eayaras/Proyecto/final.jpeg

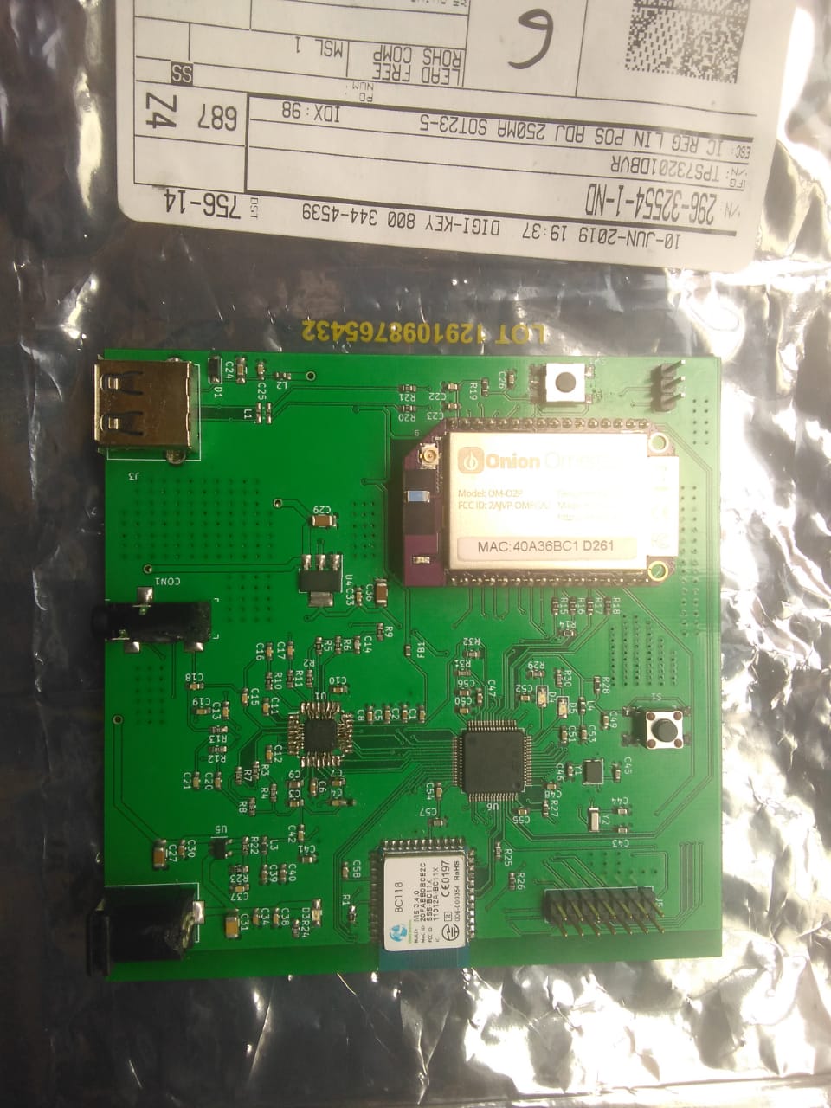
final.jpeg
