eayaras/Proyecto/omega_opt(1).jpg

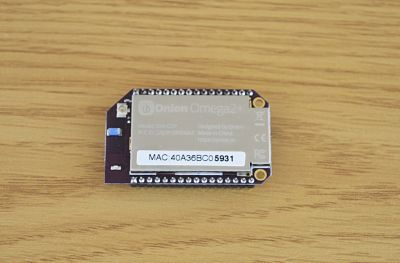
omega_opt(1).jpg
