eayaras/Proyecto/blue.JPG

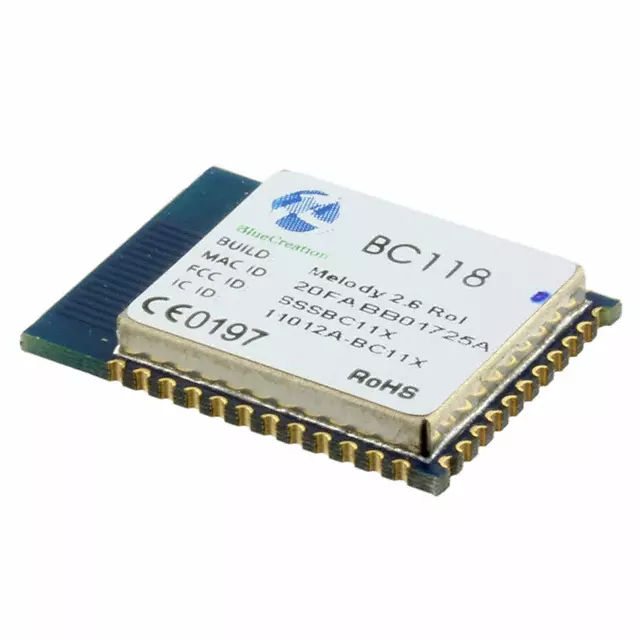
blue.JPG
