eayaras/Proyecto/CApainferior.png

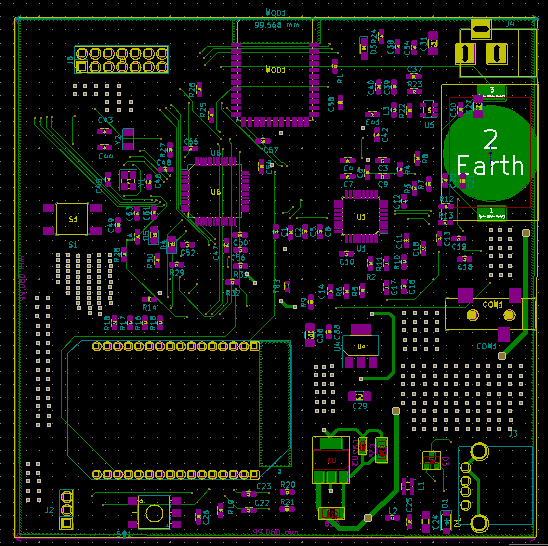
CApainferior.png
