eayaras/Proyecto/capasuperior.png

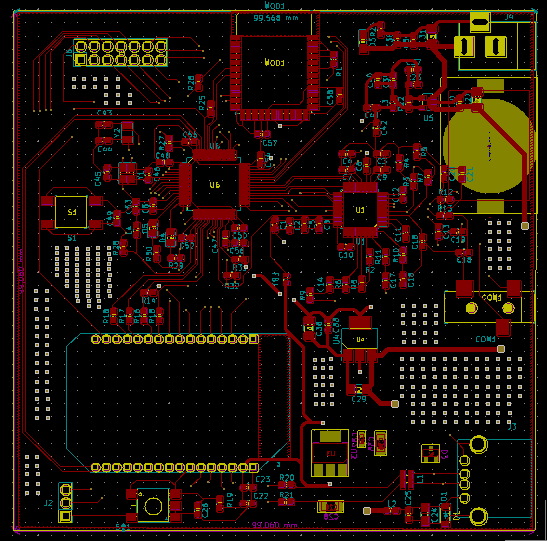
capasuperior.png
