eayaras/Proyecto/CIrcuitoIMpreso.png

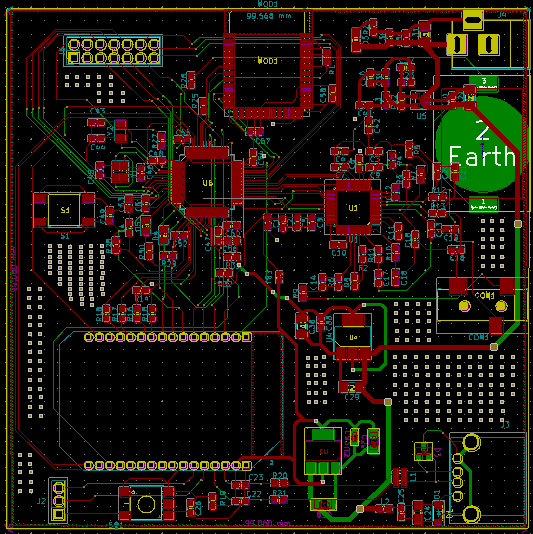
CIrcuitoIMpreso.png
