eayaras/Proyecto/corre.jpeg

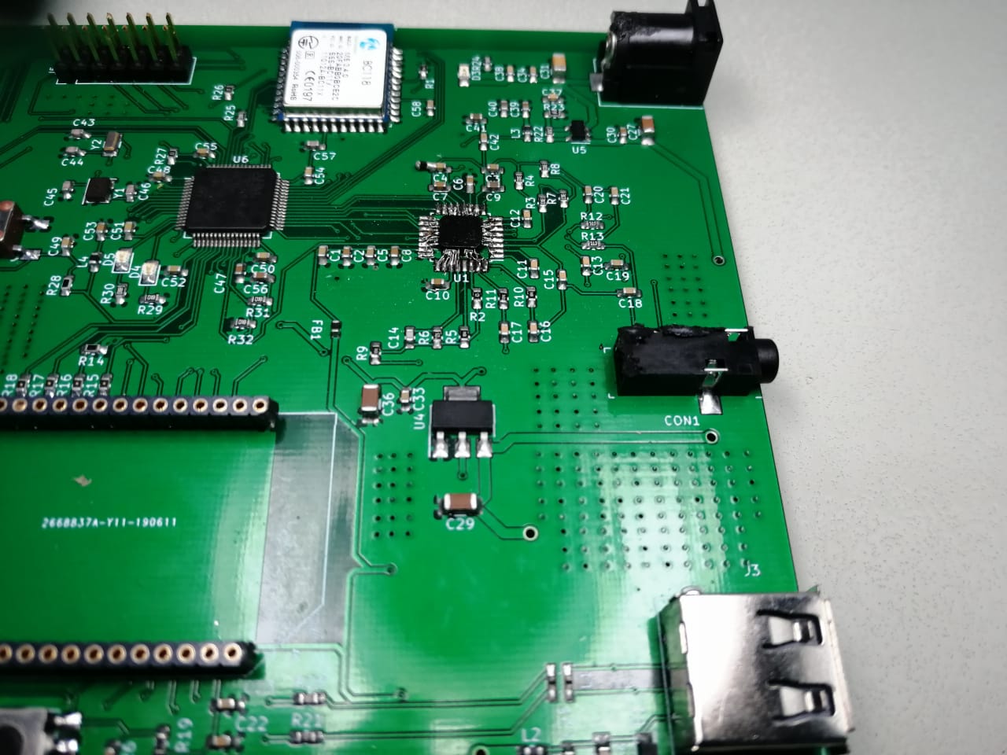
corre.jpeg
