eayaras/Proyecto/emb_3D2.png

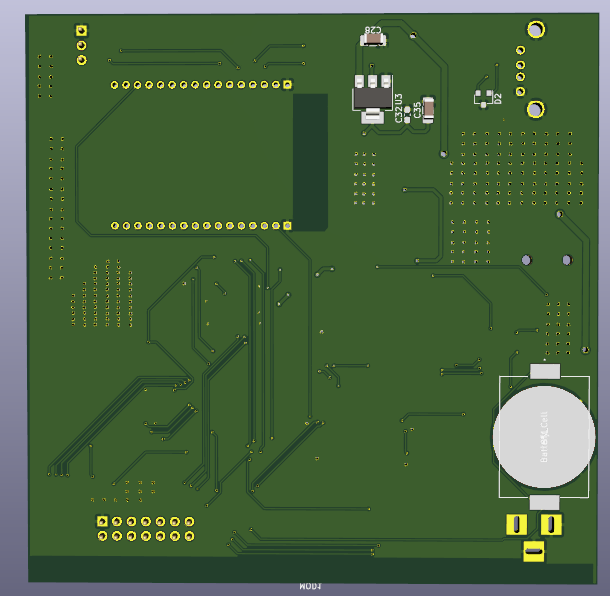
emb_3D2.png
