eayaras/Proyecto/emb_3D.png

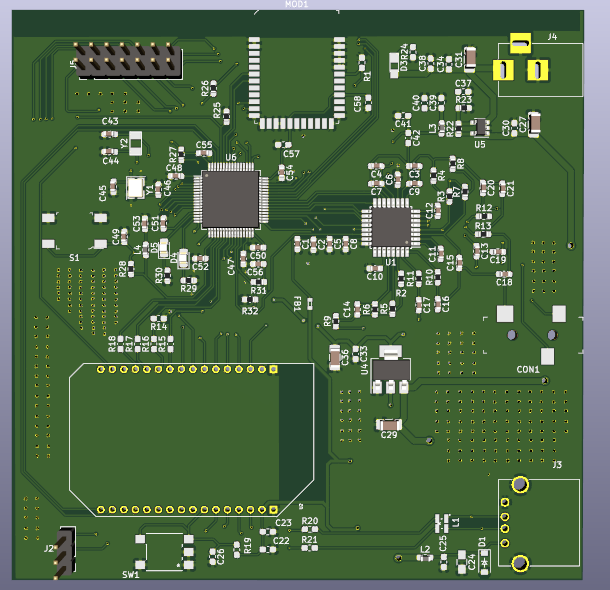
emb_3D.png
