eayaras/Proyecto/Esquema general.jpg

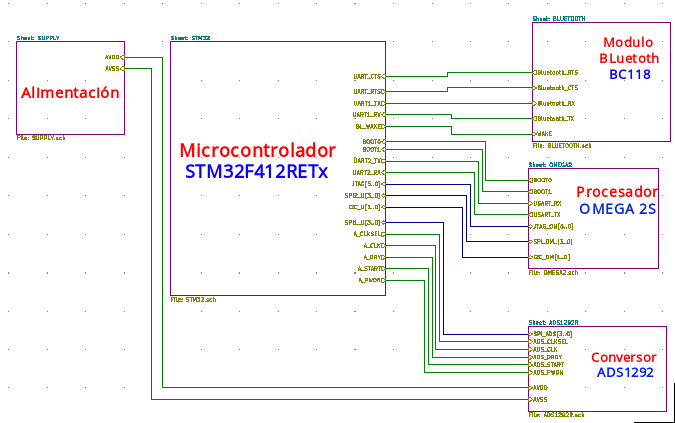
Esquema general.jpg
