eayaras/Proyecto/mainc.PNG

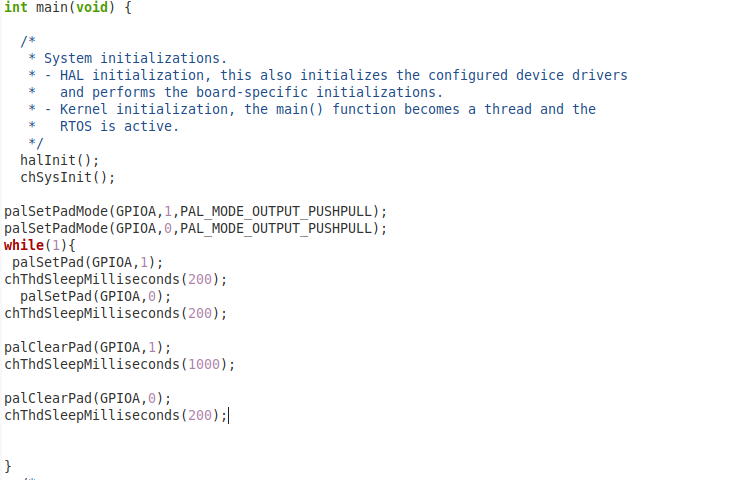
mainc.PNG
