eayaras/Proyecto/micro.png

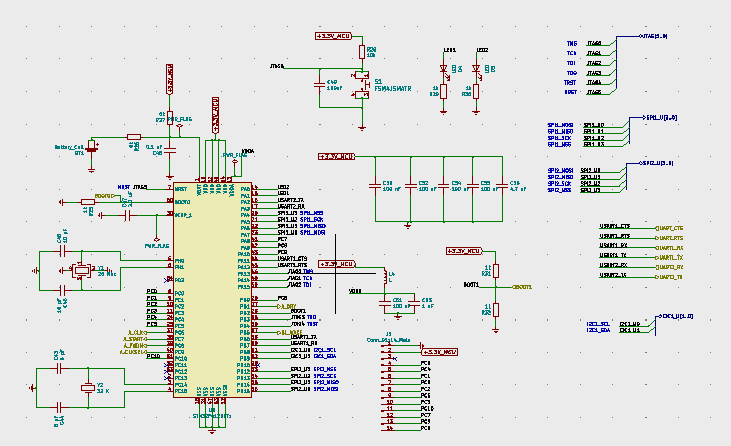
micro.png
