eayaras/Proyecto/mod_ads.png

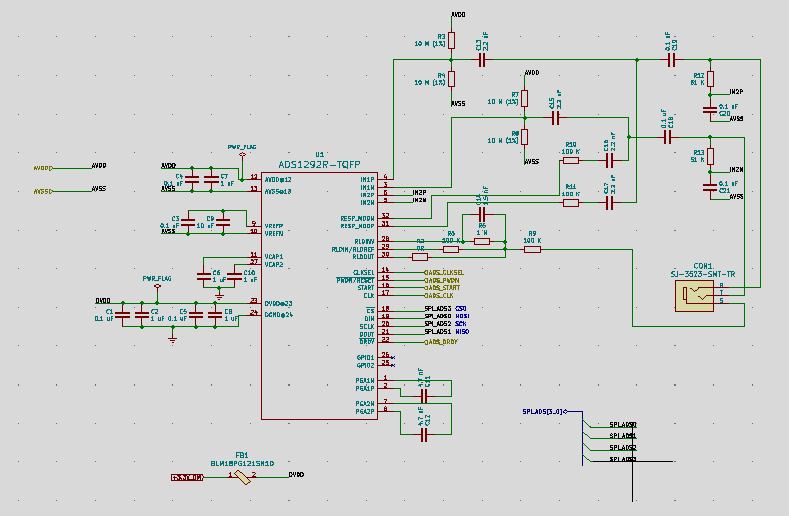
mod_ads.png
