eayaras/Proyecto/mod_bluetooth.png

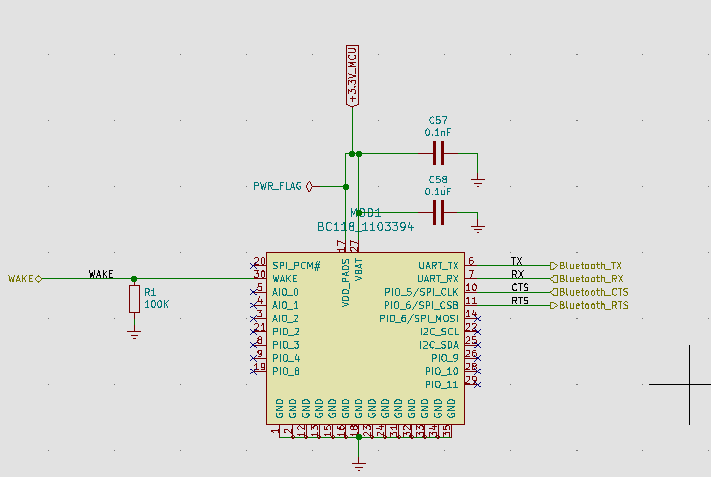
mod_bluetooth.png
