eayaras/Proyecto/onion.cfg.PNG

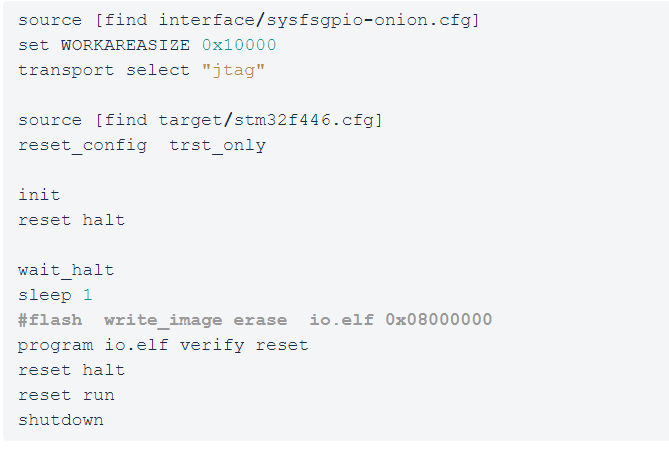
onion.cfg.PNG
