eayaras/Proyecto/onion.png

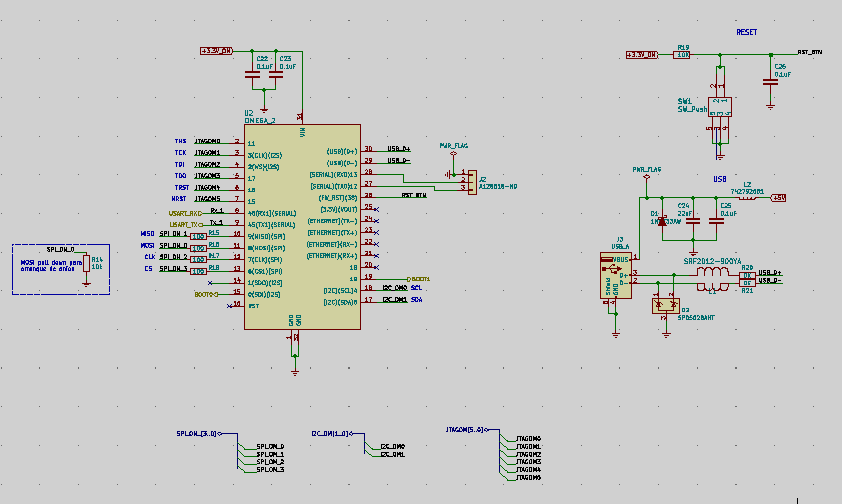
onion.png
