eayaras/Proyecto/script_programa.PNG

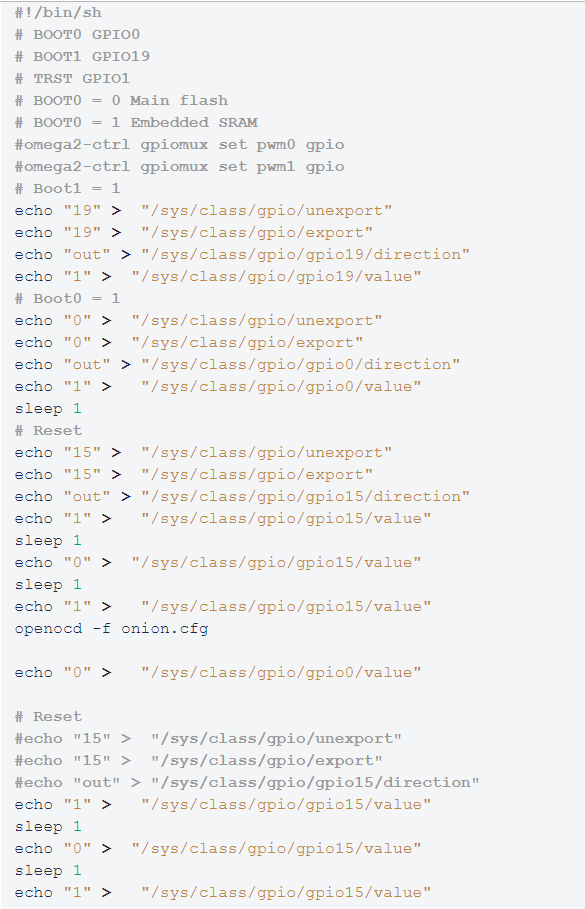
script_programa.PNG
