eayaras/Proyecto/stm.jpg

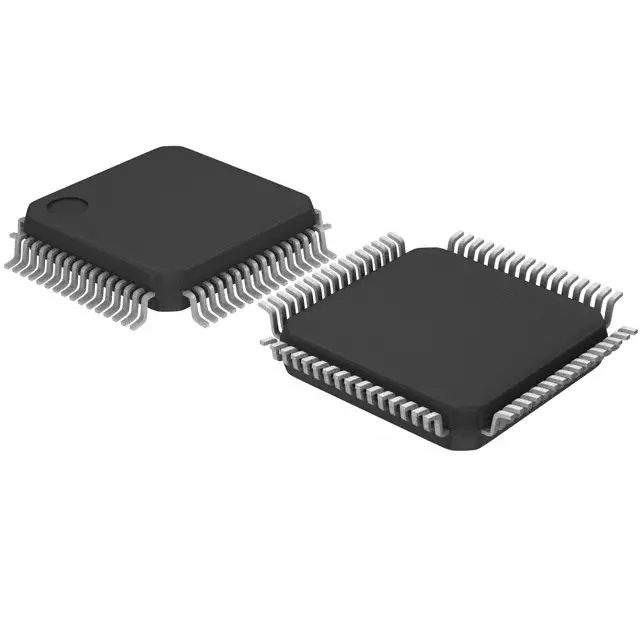
stm.jpg
