eayaras/Proyecto/supply1.png

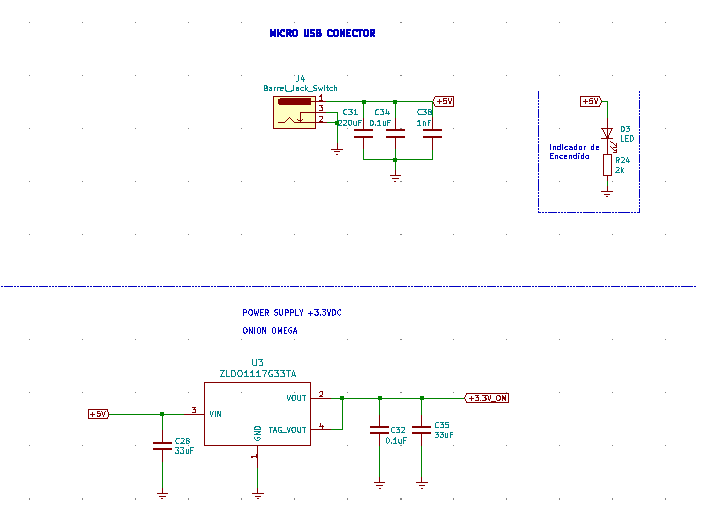
supply1.png
