eayaras/Proyecto/supply2.png

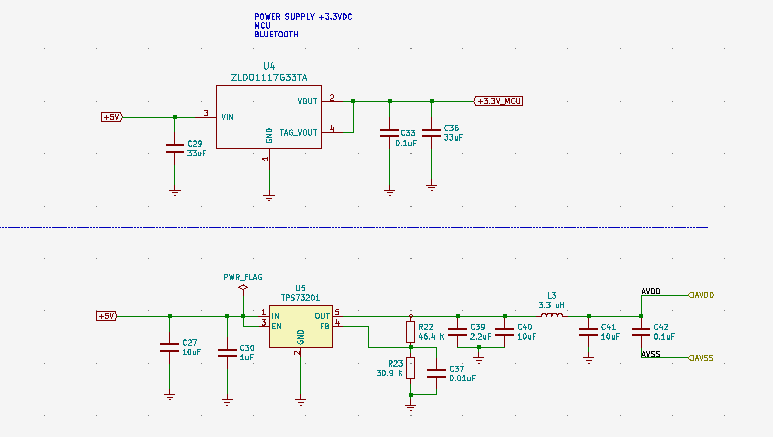
supply2.png
