eayaras/Proyecto/tarjetai.jpeg

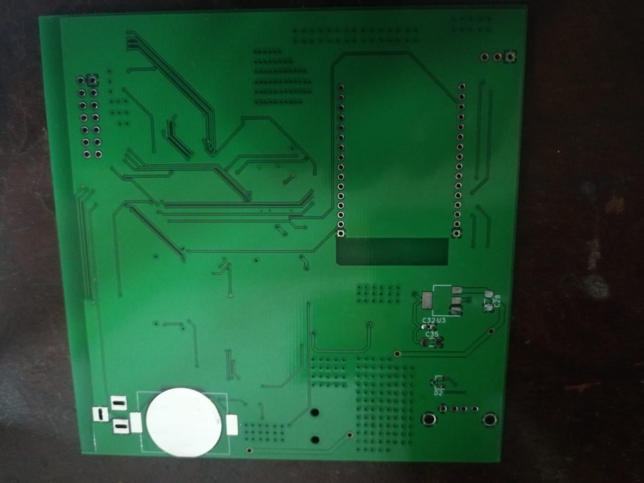
tarjetai.jpeg
