eayaras/Proyecto/tarjetas.jpeg

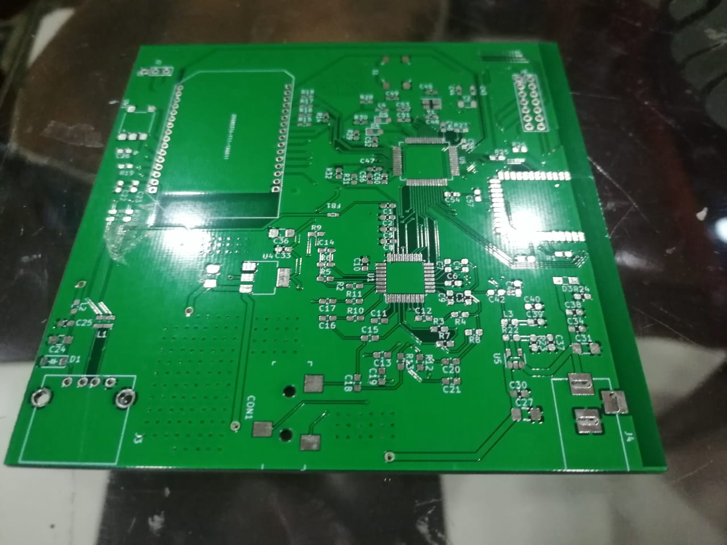
tarjetas.jpeg
