eayaras/Proyecto/Embebidos_2019.pdf

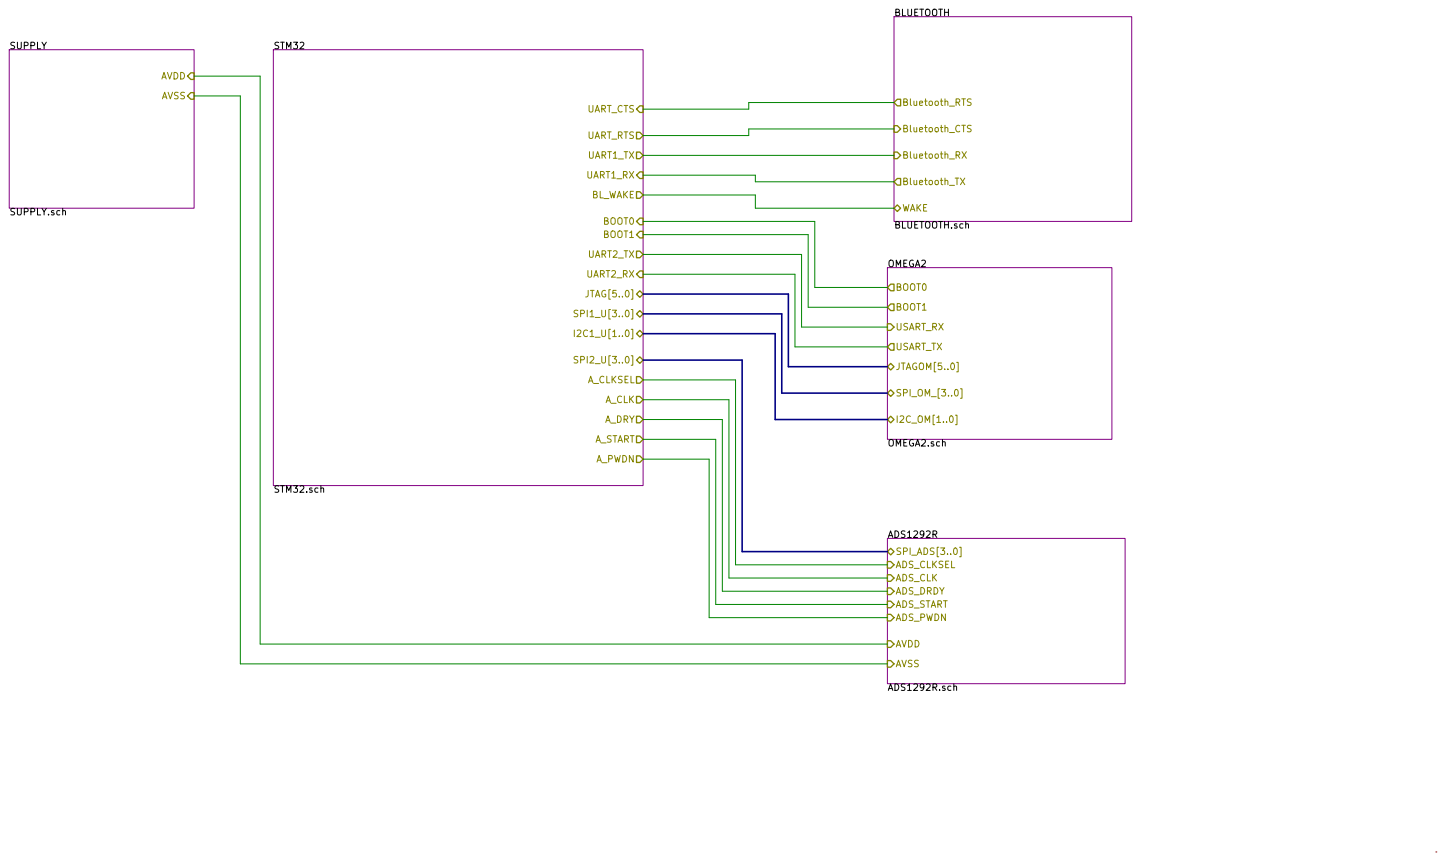
[picture p23: page 1]

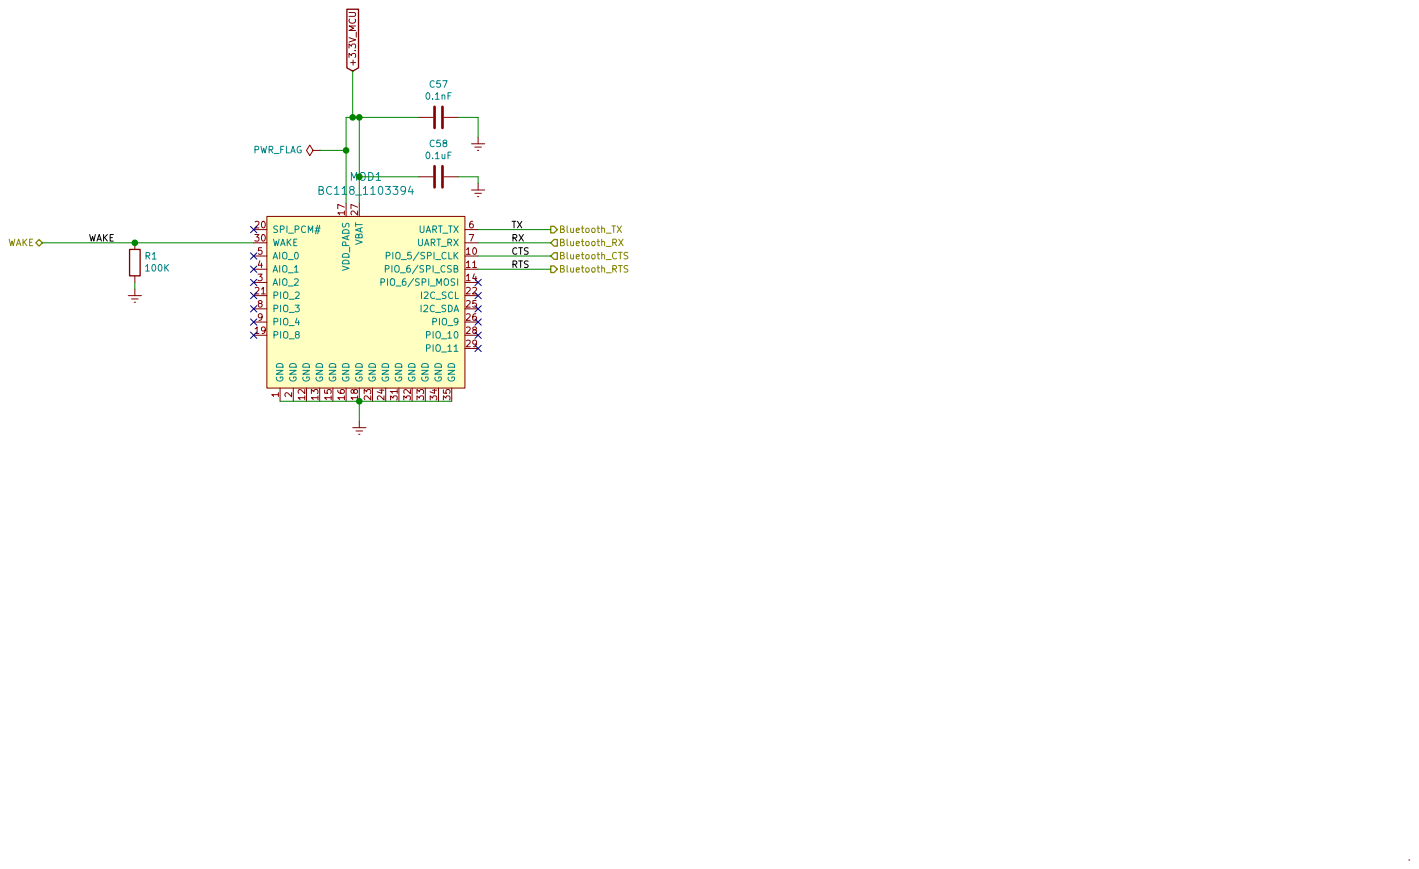
[picture p24: page 2]

GND 1 GND 2 AIO_2 3 AIO_1 4 AIO_0 5 UART_TX 6 UART_RX 7 PIO_3 8 PIO_4 9 PIO_5/SPI_CLK 10 SPI_PCM# 20 WAKE 30 PIO_6/SPI_CSB 11 PIO_2 21 GND 31 GND 12

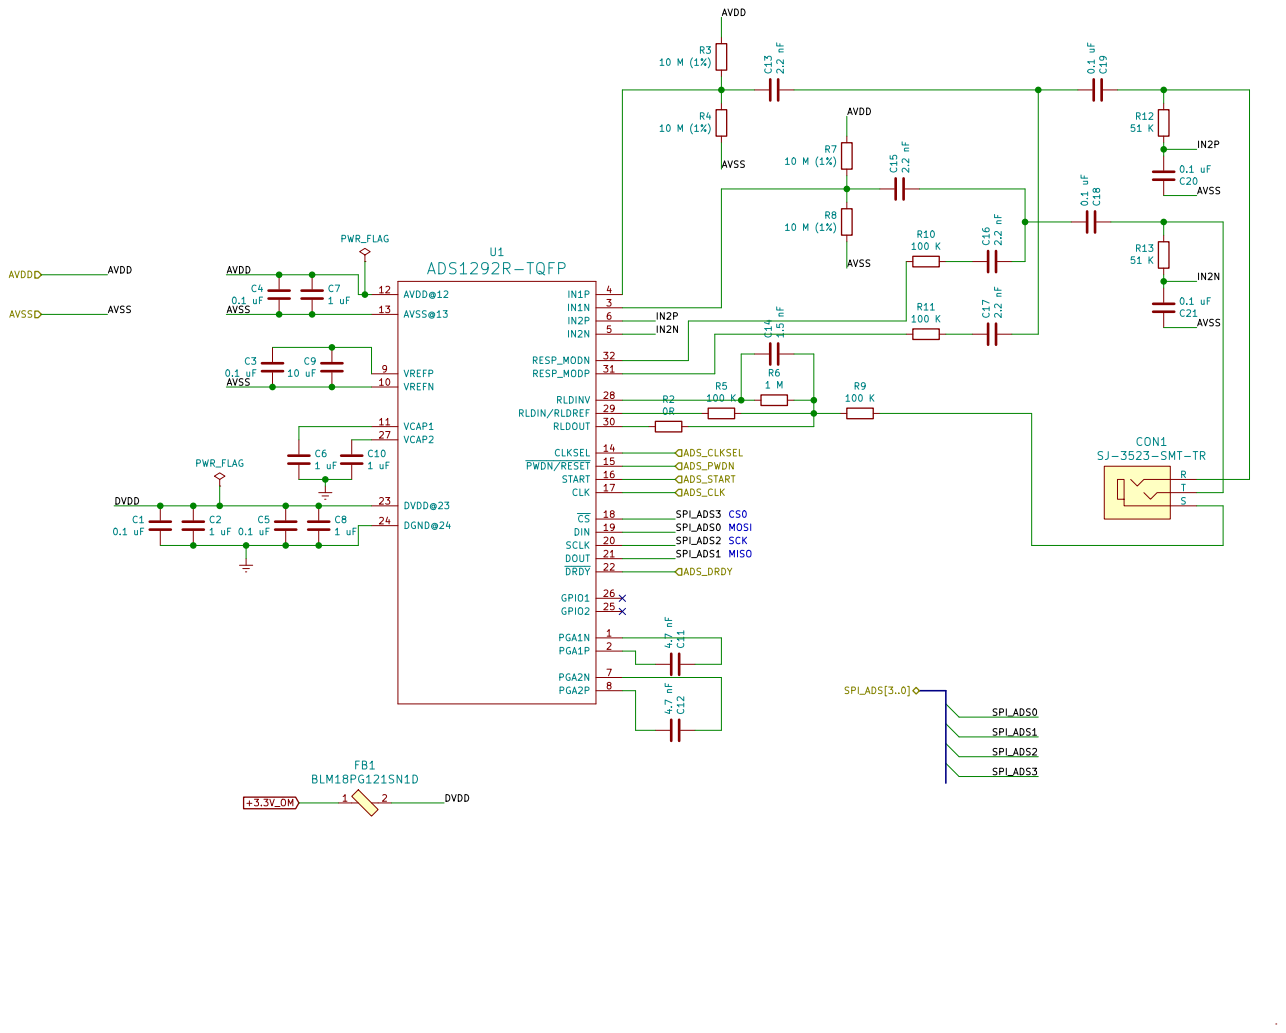
[picture p25: page 3]

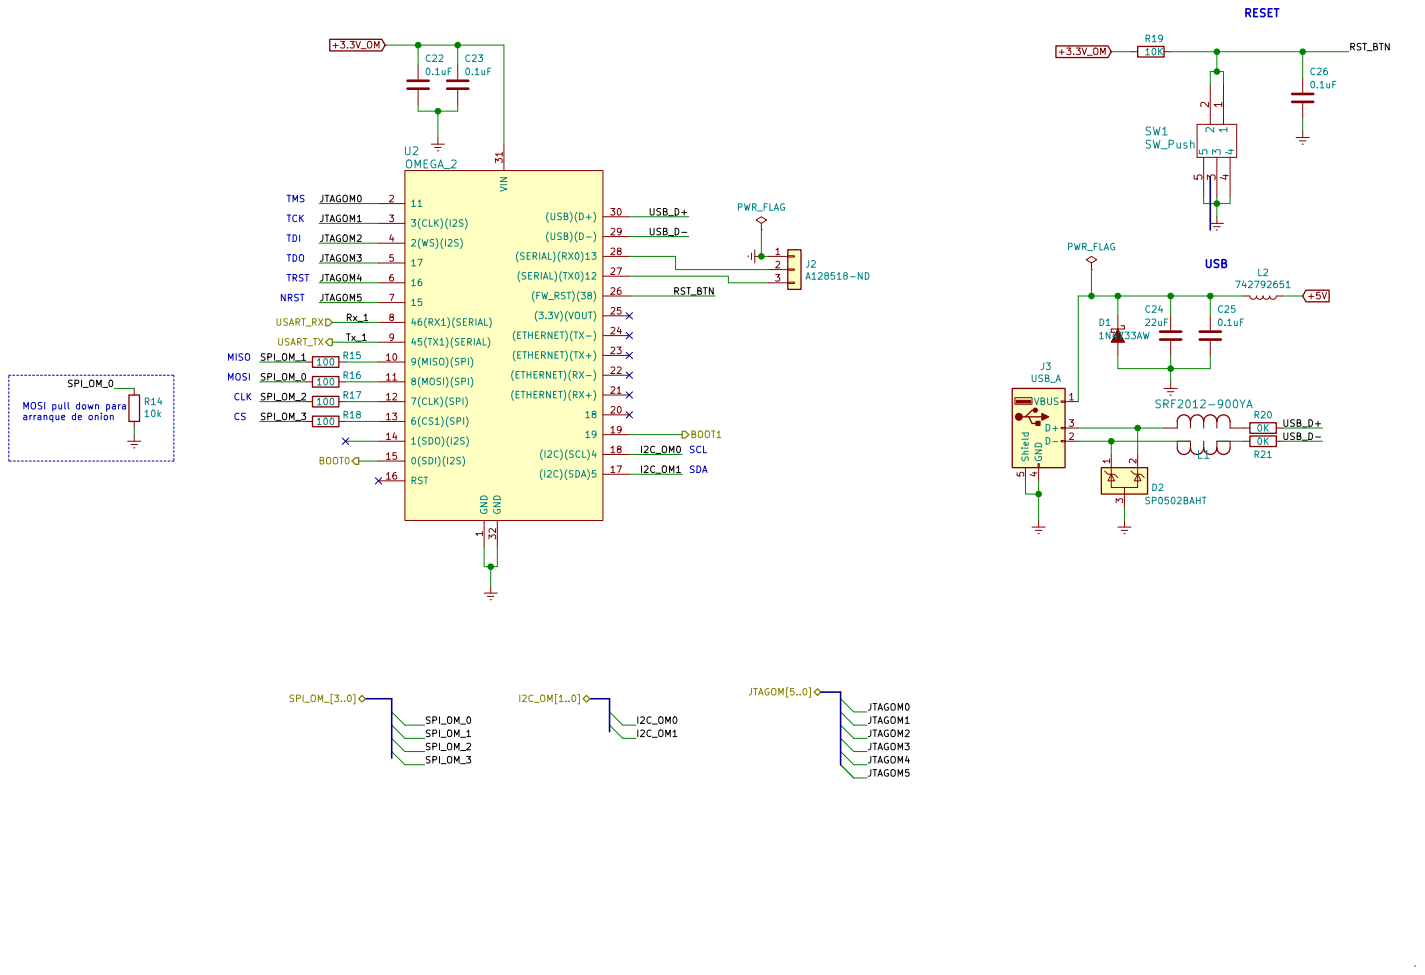
[picture p26: page 4]

10k MOSI pull down para
arranque de onion

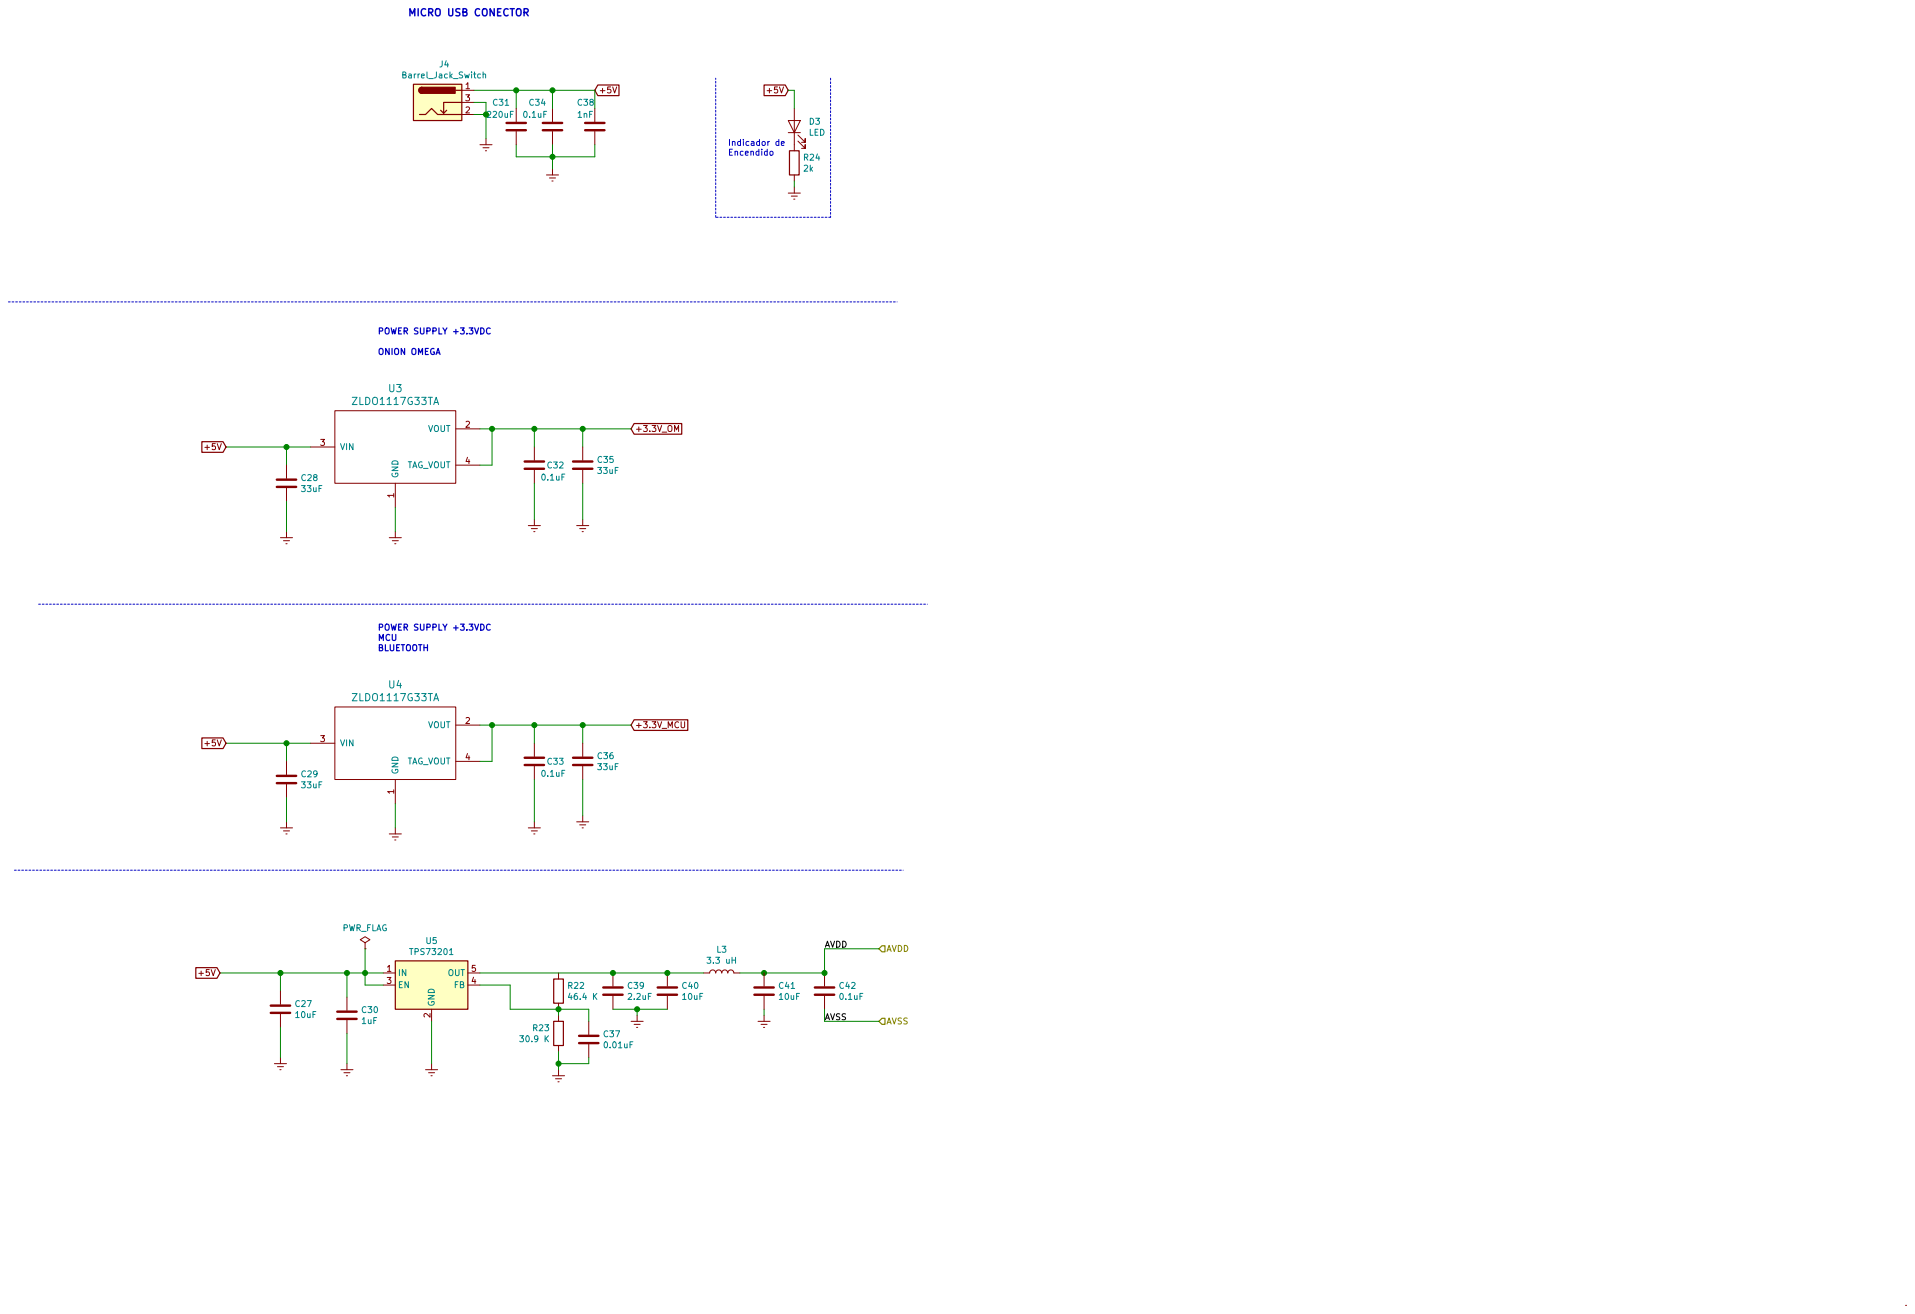
[picture p27: page 5]

0.1uF POWER SUPPLY +3.3VDC ONION OMEGA GND

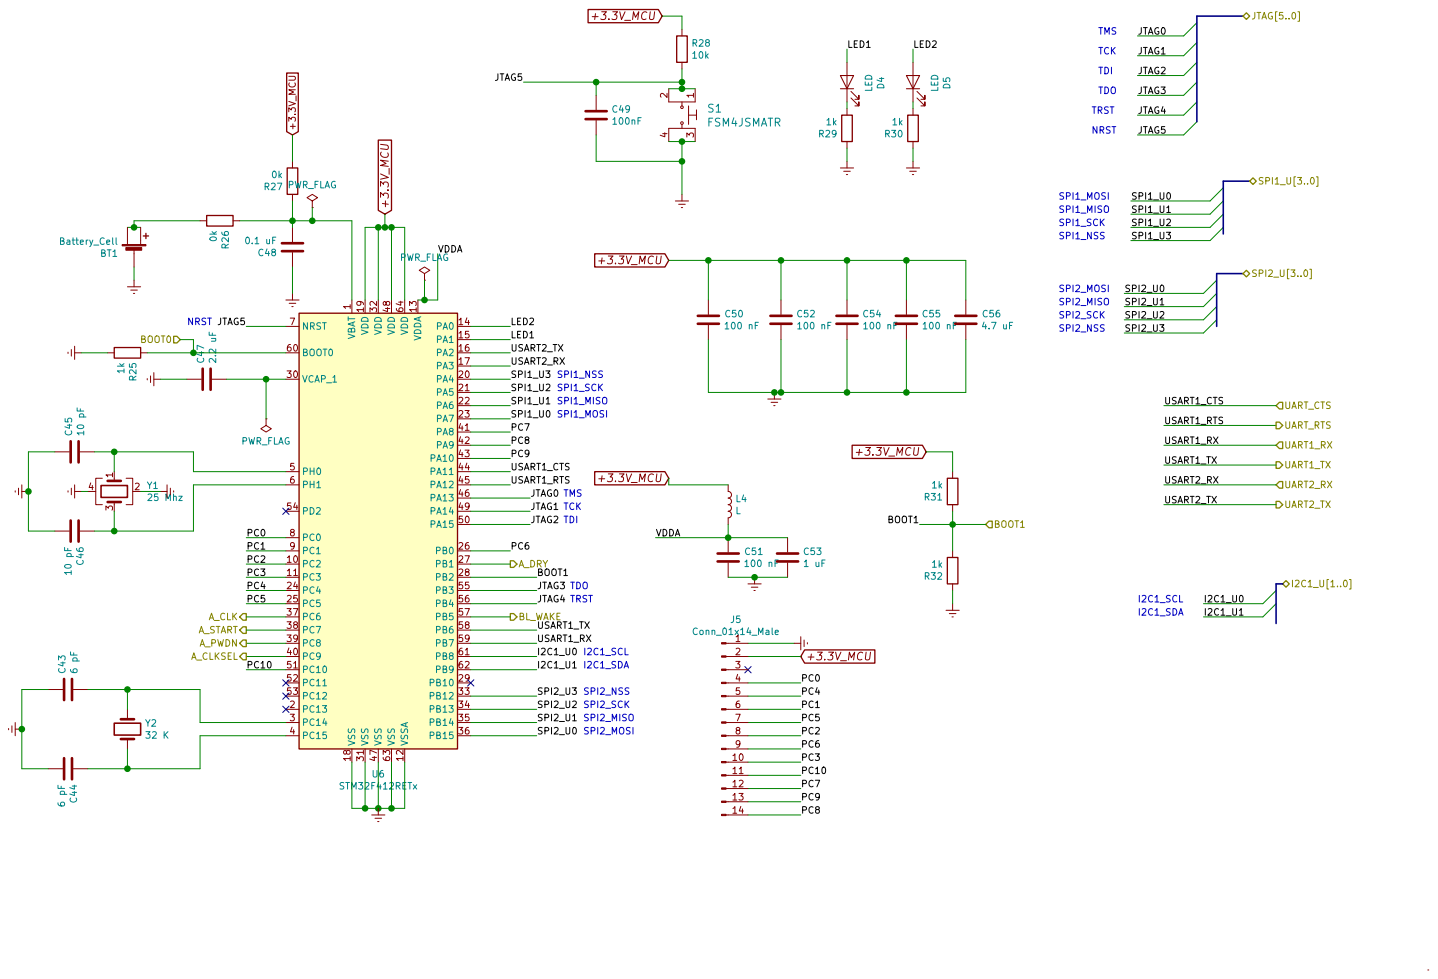
[picture p28: page 6]

1 VCAP_1 30 VDD 19 VDD 32 VDD 48 VDD 64 VDDA 13 VSS 18 VSS 31 VSS 47 VSS 63 VSSA 12 U6 STM32F412RETx
