eayaras/Proyecto/Embebidos_2019/Proyecto-master/Embebidos_2019/Embebidos_2019.kicad_pcb

## KiCad design Embebidos_2019/Proyecto-master/Embebidos_2019/Embebidos_2019.kicad_pcb (2019-06-09)

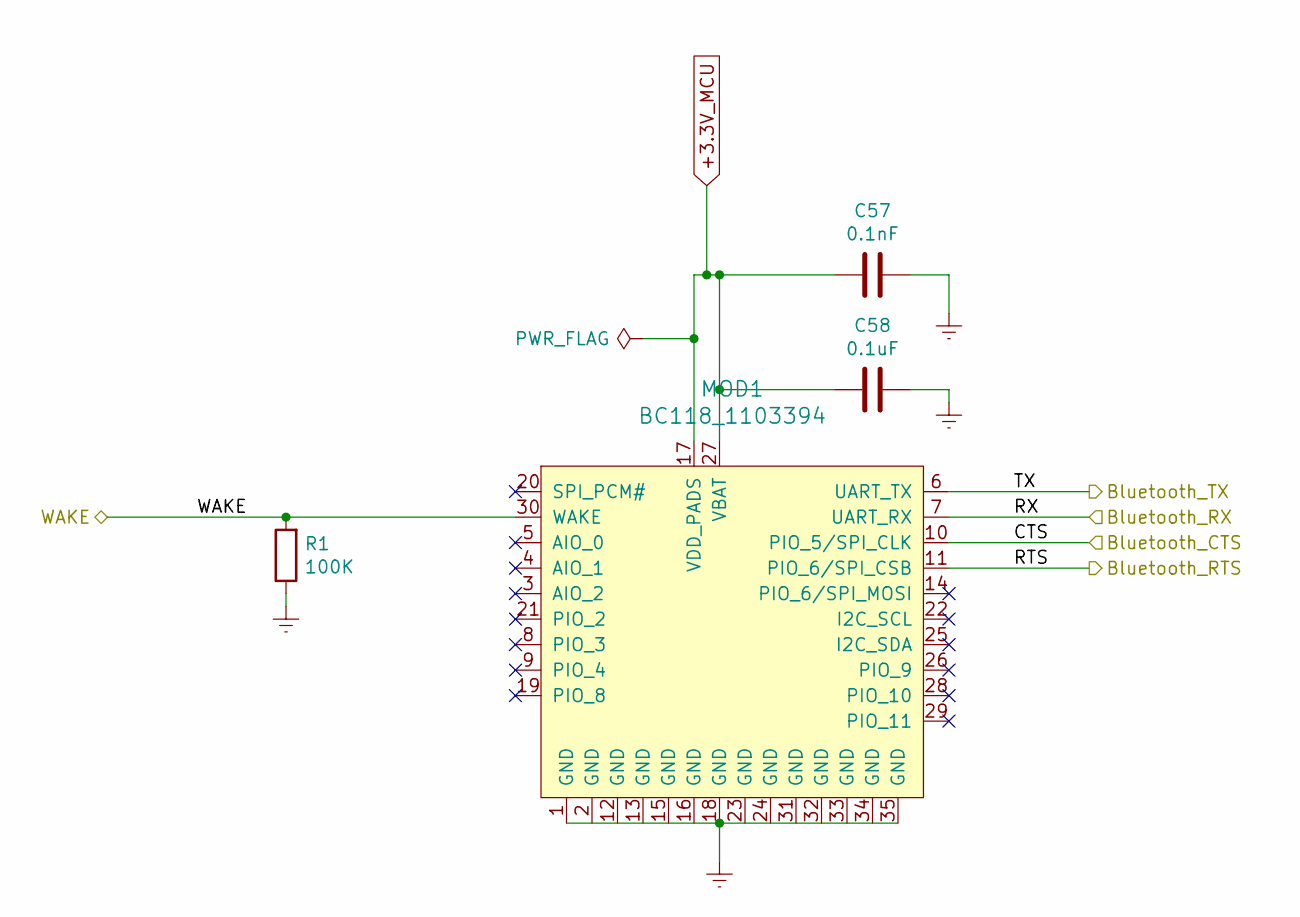
[picture p29: schematic BLUETOOTH.sch]

Parts:
C57: 0.1nF; C_0603_1608Metric_Pad1.05x0.95mm_HandSolder
C58: 0.1uF; C_0603_1608Metric_Pad1.05x0.95mm_HandSolder
MOD1: BC118_1103394; Bluetooth_Module_BC118; MPN BC118_1103394; Digi-Key_PN 1495-1003-1-ND
R1: 100K; R_0603_1608Metric_Pad1.05x0.95mm_HandSolder

Connections:
+3.3V_MCU: C57.2, C58.2, MOD1.17 (VDD_PADS), MOD1.27 (VBAT); also elsewhere on the board
/BLUETOOTH/Bluetooth_RTS: MOD1.11 (PIO_6/SPI_CSB); also elsewhere on the board
/BLUETOOTH/Bluetooth_TX: MOD1.6 (UART_TX); also elsewhere on the board
/STM32/BL_WAKE: MOD1.30 (WAKE), R1.2; also elsewhere on the board
/STM32/UART1_TX: MOD1.7 (UART_RX); also elsewhere on the board
/STM32/UART_RTS: MOD1.10 (PIO_5/SPI_CLK); also elsewhere on the board
Earth: C57.1, C58.1, MOD1.1 (GND), MOD1.2 (GND), MOD1.12 (GND), MOD1.13 (GND), MOD1.15 (GND), MOD1.16 (GND), MOD1.18 (GND), MOD1.23 (GND), MOD1.24 (GND), MOD1.31 (GND), MOD1.32 (GND), MOD1.33 (GND), MOD1.34 (GND), MOD1.35 (GND), R1.1; also elsewhere on the board

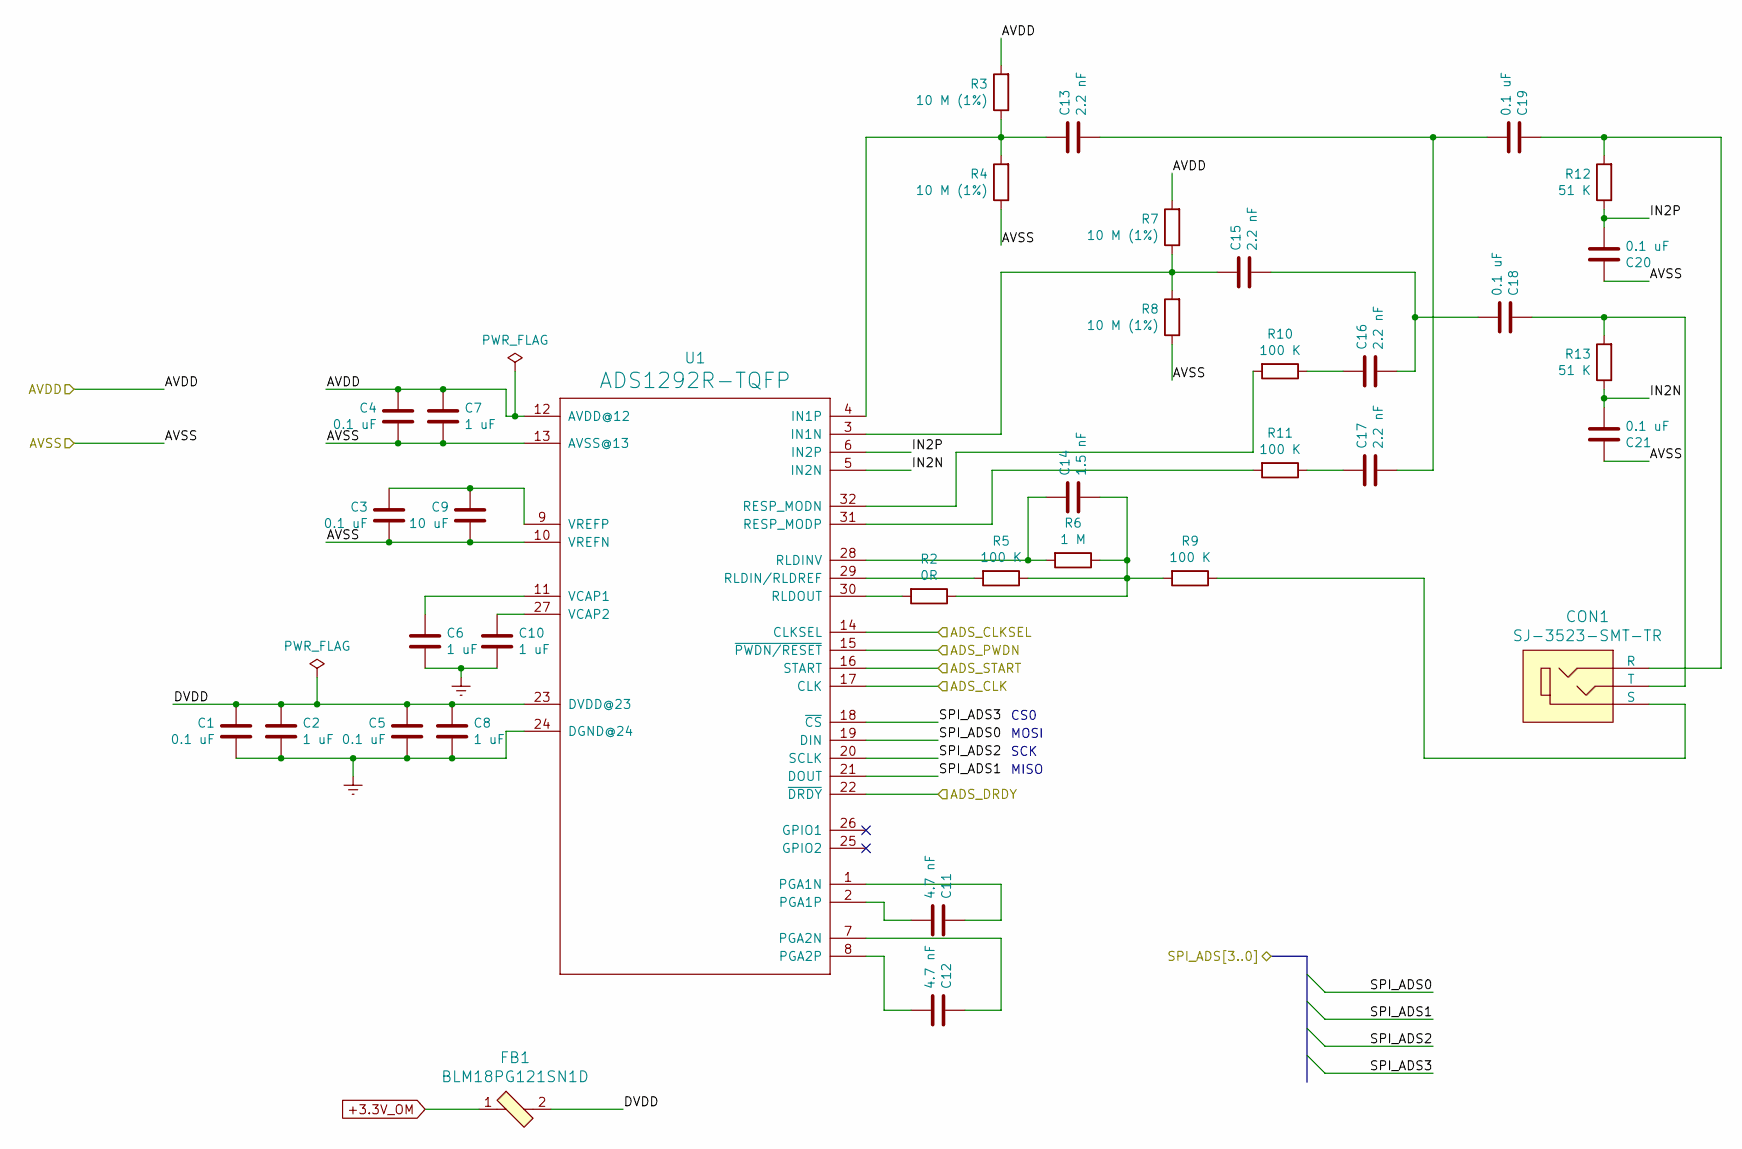
[picture p30: schematic ADS1292R.sch]

Parts:
C1, C3, C4, C5, C18, C19, C20, C21: 0.1 uF; C_0603_1608Metric_Pad1.05x0.95mm_HandSolder
C2, C6, C7, C8, C10: 1 uF; C_0603_1608Metric_Pad1.05x0.95mm_HandSolder
C9: 10 uF; C_0603_1608Metric_Pad1.05x0.95mm_HandSolder
C11, C12: 4.7 nF; C_0603_1608Metric_Pad1.05x0.95mm_HandSolder
C13, C15, C16, C17: 2.2 nF; C_0603_1608Metric_Pad1.05x0.95mm_HandSolder
C14: 1.5 nF; C_0603_1608Metric_Pad1.05x0.95mm_HandSolder
CON1: SJ-3523-SMT-TR; Switch_Slide_11.6x4mm_SJ-3523-SMT; MPN SJ-3523-SMT-TR; Digi-Key_PN CP-3523SJCT-ND
FB1: BLM18PG121SN1D; 0603; MPN BLM18PG121SN1D; Digi-Key_PN 490-1037-1-ND
R2: 0R; R_0603_1608Metric_Pad1.05x0.95mm_HandSolder
R3, R4, R7, R8: 10 M (1%); R_0603_1608Metric_Pad1.05x0.95mm_HandSolder
R5, R9, R10, R11: 100 K; R_0603_1608Metric_Pad1.05x0.95mm_HandSolder
R6: 1 M; R_0603_1608Metric_Pad1.05x0.95mm_HandSolder
R12, R13: 51 K; R_0603_1608Metric_Pad1.05x0.95mm_HandSolder
U1: ADS1292R-TQFP; TQFP-32_7x7mm_P0.8mm

Connections:
+3.3V_OM: FB1.1; also elsewhere on the board
/ADS1292R/AVDD: C4.1, C7.1, R3.2, R7.2, U1.12 (AVDD@12); also elsewhere on the board
/ADS1292R/DVDD: C1.1, C2.1, C5.1, C8.1, FB1.2, U1.23 (DVDD@23)
/ADS1292R/IN2N: C21.2, R13.1, U1.5 (IN2N)
/ADS1292R/IN2P: C20.2, R12.1, U1.6 (IN2P)
/ADS1292R/SPI_ADS0: U1.19 (DIN); also elsewhere on the board
/ADS1292R/SPI_ADS1: U1.21 (DOUT); also elsewhere on the board
/ADS1292R/SPI_ADS2: U1.20 (SCLK); also elsewhere on the board
/ADS1292R/SPI_ADS3: U1.18 (~CS); also elsewhere on the board
/STM32/A_CLK: U1.17 (CLK); also elsewhere on the board
/STM32/A_CLKSEL: U1.14 (CLKSEL); also elsewhere on the board
/STM32/A_DRY: U1.22 (~DRDY); also elsewhere on the board
/STM32/A_PWDN: U1.15 (~PWDN/RESET); also elsewhere on the board
/STM32/A_START: U1.16 (START); also elsewhere on the board
/SUPPLY/AVSS: C3.2, C4.2, C7.2, C9.2, C20.1, C21.1, R4.1, R8.1, U1.10 (VREFN), U1.13 (AVSS@13); also elsewhere on the board
Earth: C1.2, C2.2, C5.2, C6.2, C8.2, C10.2, U1.24 (DGND@24); also elsewhere on the board
unnamed: C3.1, C9.1, U1.9 (VREFP)
unnamed: C6.1, U1.11 (VCAP1)
unnamed: C10.1, U1.27 (VCAP2)
unnamed: C11.1, U1.1 (PGA1N)
unnamed: C11.2, U1.2 (PGA1P)
unnamed: C12.1, U1.7 (PGA2N)
unnamed: C12.2, U1.8 (PGA2P)
unnamed: C13.1, R3.1, R4.2, U1.4 (IN1P)
unnamed: C13.2, C17.2, C19.2
unnamed: C14.1, R6.2, U1.28 (RLDINV)
unnamed: C14.2, R2.1, R5.1, R6.1, R9.2
unnamed: C15.1, R7.1, R8.2, U1.3 (IN1N)
unnamed: C15.2, C16.2, C18.2
unnamed: C16.1, R10.1
unnamed: C17.1, R11.1
unnamed: C18.1, CON1.2 (T), R13.2
unnamed: C19.1, CON1.3 (R), R12.2
unnamed: CON1.1 (S), R9.1
unnamed: R2.2, U1.30 (RLDOUT)
unnamed: R5.2, U1.29 (RLDIN/RLDREF)
unnamed: R10.2, U1.32 (RESP_MODN)
unnamed: R11.2, U1.31 (RESP_MODP)

Notes on the sheet:
MOSI
MISO
SCK
CS0

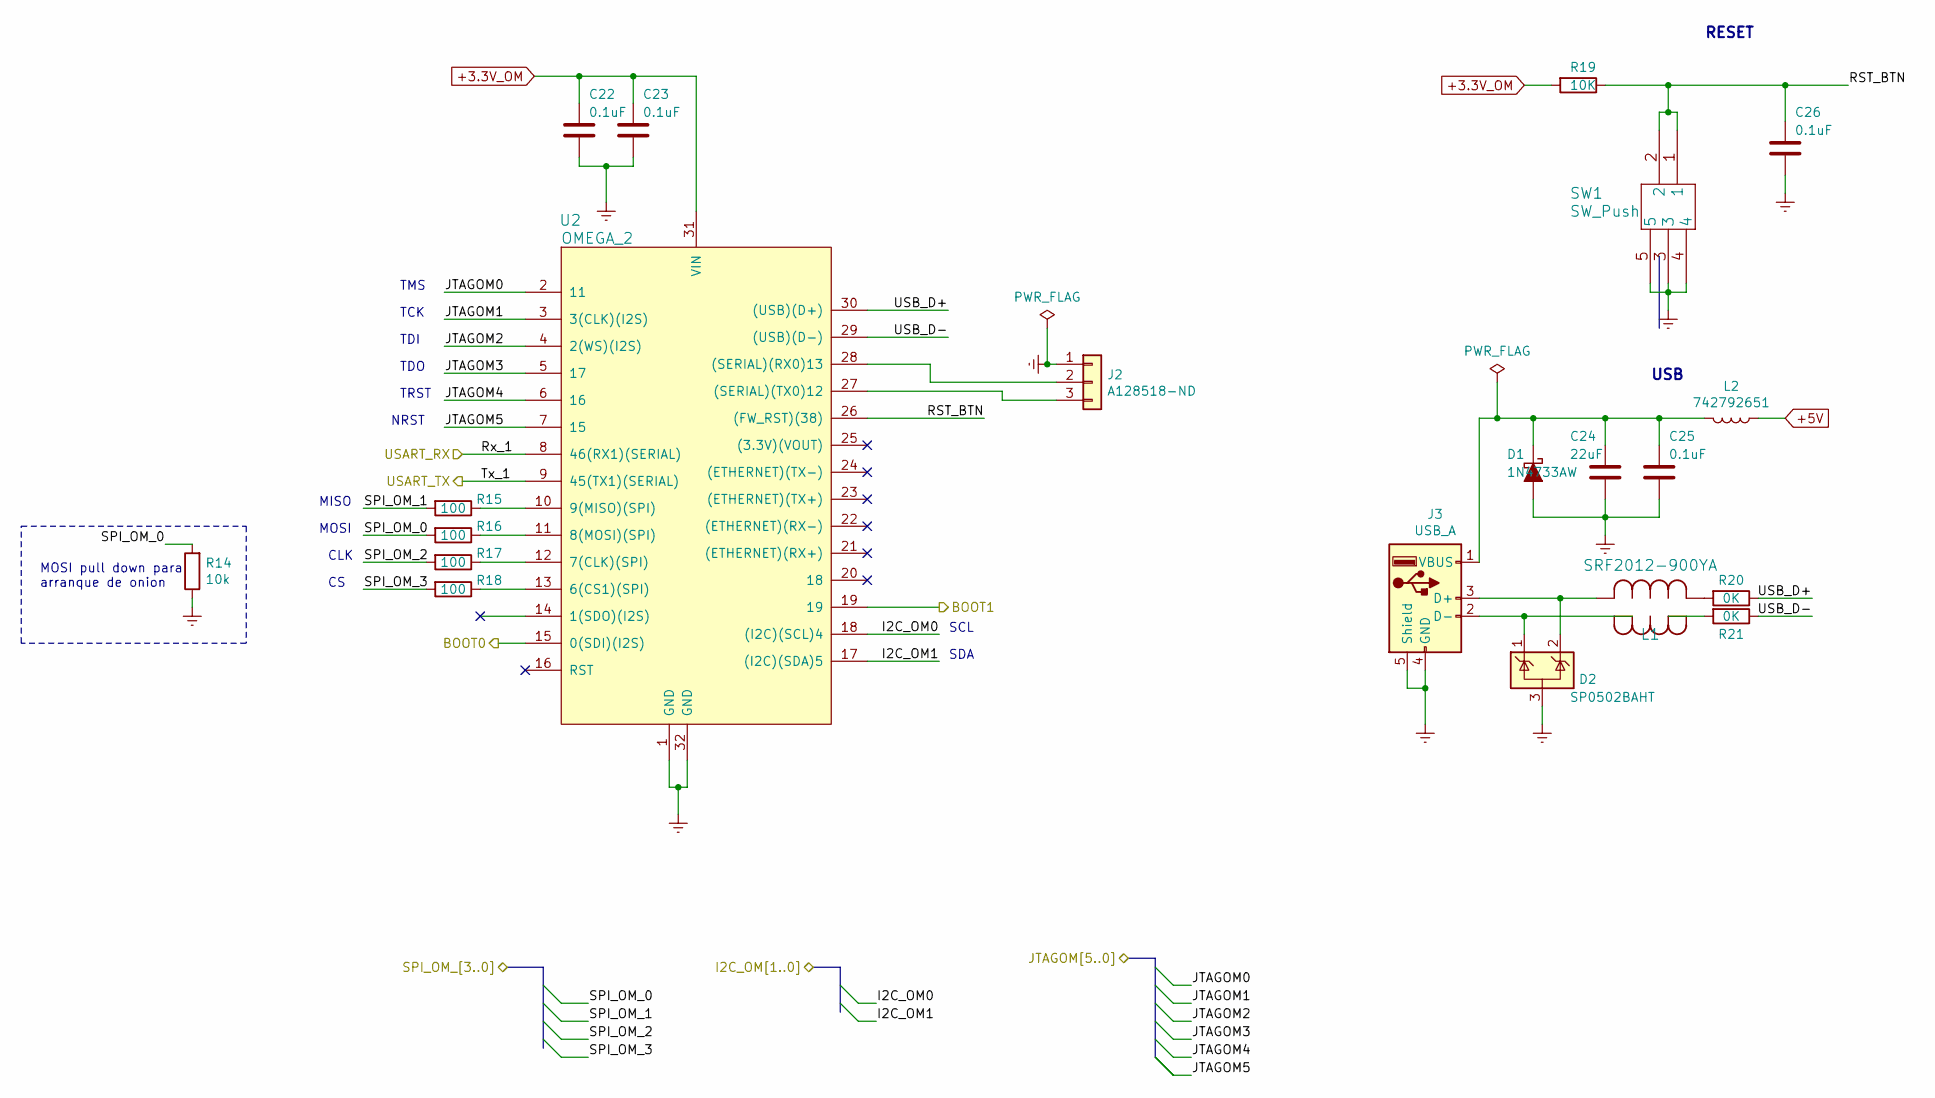
[picture p31: schematic OMEGA2.sch]

Parts:
C22, C23, C25, C26: 0.1uF; C_0603_1608Metric_Pad1.05x0.95mm_HandSolder
C24: 22uF; C_0805_HandSoldering
D1: 1N4733AW; DO-214AC; DigiKey BZT52C5V1-TPMSCT-ND
D2: SP0502BAHT; SOT-23; DigiKey F2714CT-ND
J2: A128518-ND; PinHeader_1x03_P2.54mm_Vertical
J3: USB_A; Digikey 380-1412-ND
L1: SRF2012-900YA; DigiKey SRF2012-900YACT-ND
L2: 742792651; L_0603_1608Metric_Pad1.05x0.95mm_HandSolder; DigiKey 732-1593-1-ND
R14: 10k; C_0603_1608Metric_Pad1.05x0.95mm_HandSolder
R15, R17, R18: 100; R_0603_1608Metric_Pad1.05x0.95mm_HandSolder
R16: 100; C_0603_1608Metric_Pad1.05x0.95mm_HandSolder
R19: 10K; R_0603_1608Metric_Pad1.05x0.95mm_HandSolder
R20, R21: 0K; R_0603_1608Metric_Pad1.05x0.95mm_HandSolder
SW1: SW_Push; FSM1LPTR; DigiKey 450-1756-1-ND
U2: OMEGA_2; ONION-OMEGA

Connections:
+3.3V_OM: C22.1, C23.1, R19.2, U2.31 (VIN); also elsewhere on the board
+5V: L2.1; also elsewhere on the board
/OMEGA2/BOOT0: U2.15 (0(SDI)(I2S)); also elsewhere on the board
/OMEGA2/BOOT1: U2.19; also elsewhere on the board
/OMEGA2/I2C_OM0: U2.18 ((I2C)(SCL)4); also elsewhere on the board
/OMEGA2/I2C_OM1: U2.17 ((I2C)(SDA)5); also elsewhere on the board
/OMEGA2/RST_BTN: C26.1, R19.1, SW1.1, SW1.2, U2.26 ((FW_RST)(38))
/OMEGA2/USART_TX: U2.9 (45(TX1)(SERIAL)); also elsewhere on the board
/OMEGA2/USB_D+: R20.1, U2.30 ((USB)(D+))
/OMEGA2/USB_D-: R21.1, U2.29 ((USB)(D-))
/STM32/JTAG0: U2.2 (11); also elsewhere on the board
/STM32/JTAG1: U2.3 (3(CLK)(I2S)); also elsewhere on the board
/STM32/JTAG2: U2.4 (2(WS)(I2S)); also elsewhere on the board
/STM32/JTAG3: U2.5 (17); also elsewhere on the board
/STM32/JTAG4: U2.6 (16); also elsewhere on the board
/STM32/JTAG5: U2.7 (15); also elsewhere on the board
/STM32/SPI1_U0: R14.2, R16.2; also elsewhere on the board
/STM32/SPI1_U1: R15.2; also elsewhere on the board
/STM32/SPI1_U2: R17.2; also elsewhere on the board
/STM32/SPI1_U3: R18.2; also elsewhere on the board
/STM32/UART2_TX: U2.8 (46(RX1)(SERIAL)); also elsewhere on the board
Earth: C22.2, C23.2, C24.2, C25.2, C26.2, D1.2 (A), D2.3 (A), J2.1, J3.4 (GND), J3.5 (Shield), R14.1, SW1.3, SW1.4, SW1.5, U2.1 (GND), U2.32 (GND); also elsewhere on the board
unnamed: C24.1, C25.1, D1.1 (K), J3.1 (VBUS), L2.2
unnamed: D2.1 (K), J3.2 (D-), L1.4
unnamed: D2.2 (K), J3.3 (D+), L1.1
unnamed: J2.2, U2.28 ((SERIAL)(RX0)13)
unnamed: J2.3, U2.27 ((SERIAL)(TX0)12)
unnamed: L1.2, R20.2
unnamed: L1.3, R21.2
unnamed: R15.1, U2.10 (9(MISO)(SPI))
unnamed: R16.1, U2.11 (8(MOSI)(SPI))
unnamed: R17.1, U2.12 (7(CLK)(SPI))
unnamed: R18.1, U2.13 (6(CS1)(SPI))

Notes on the sheet:
USB
RESET
MOSI pull down para arranque de onion
MOSI
MISO
CLK
SCL
SDA
TMS
TCK
TDI
TDO
TRST
NRST

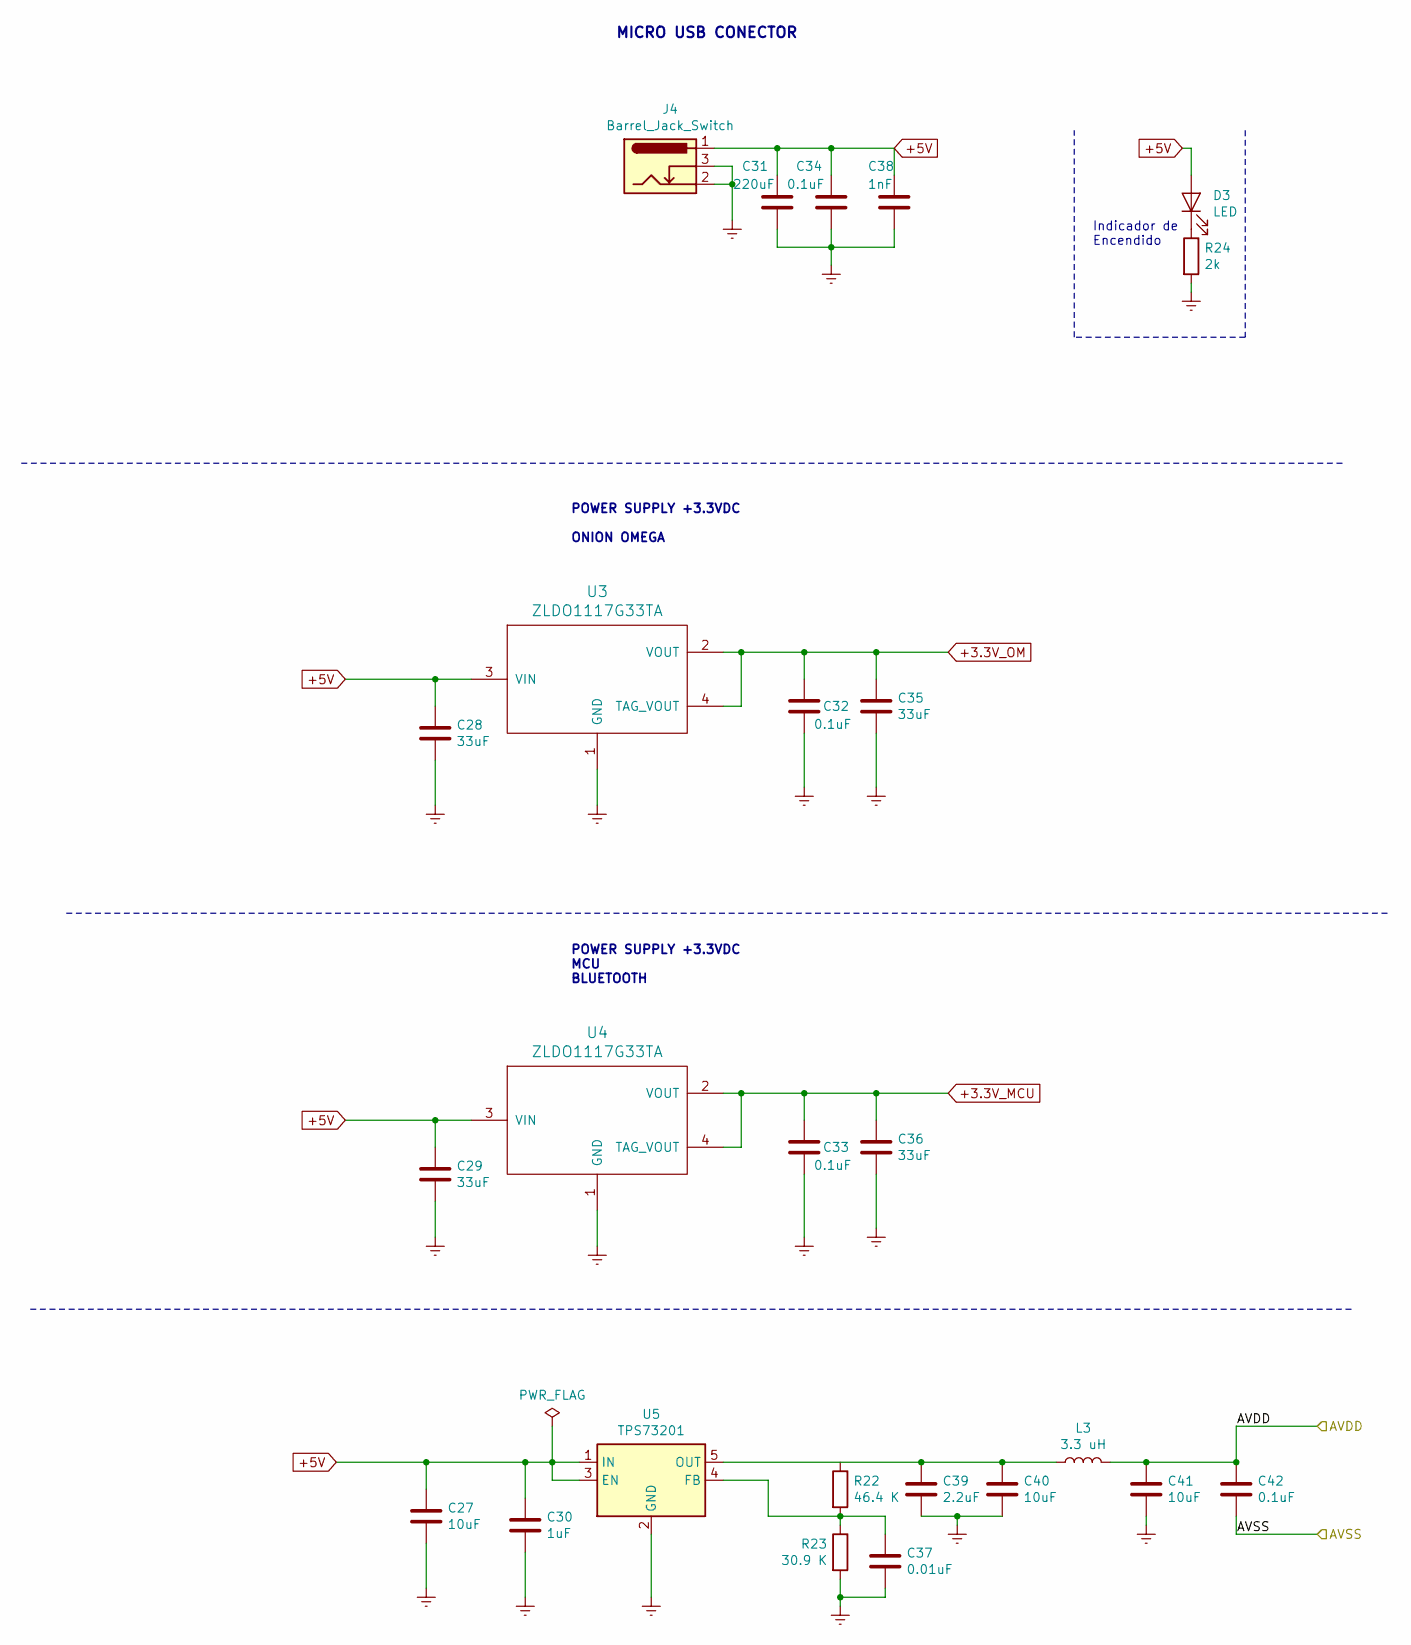
[picture p32: schematic SUPPLY.sch]

Parts:
C27: 10uF; C_1206_3216Metric_Pad1.42x1.75mm_HandSolder
C28, C29, C35, C36: 33uF; C_1206_3216Metric_Pad1.42x1.75mm_HandSolder
C30: 1uF; C_0603_1608Metric_Pad1.05x0.95mm_HandSolder
C31: 220uF; C_1206_3216Metric_Pad1.42x1.75mm_HandSolder
C32, C33, C34, C42: 0.1uF; C_0603_1608Metric_Pad1.05x0.95mm_HandSolder
C37: 0.01uF; C_0603_1608Metric_Pad1.05x0.95mm_HandSolder
C38: 1nF; C_0603_1608Metric_Pad1.05x0.95mm_HandSolder
C39: 2.2uF; C_0603_1608Metric_Pad1.05x0.95mm_HandSolder
C40, C41: 10uF; C_0603_1608Metric_Pad1.05x0.95mm_HandSolder
D3: LED; LED_0805_HandSoldering
J4: Barrel_Jack_Switch; BARREL_JACK; DigiKey CP-002A-ND
L3: 3.3 uH; L_0603_1608Metric_Pad1.05x0.95mm_HandSolder
R22: 46.4 K; R_0603_1608Metric_Pad1.05x0.95mm_HandSolder
R23: 30.9 K; R_0603_1608Metric_Pad1.05x0.95mm_HandSolder
R24: 2k; R_0603_1608Metric_Pad1.05x0.95mm_HandSolder
U3, U4: ZLDO1117G33TA; SOT-223; DigiKey ZLDO1117G33DICT-ND
U5: TPS73201; SOT-23-5

Connections:
+3.3V_MCU: C33.1, C36.1, U4.2 (VOUT), U4.4 (TAG_VOUT); also elsewhere on the board
+3.3V_OM: C32.1, C35.1, U3.2 (VOUT), U3.4 (TAG_VOUT); also elsewhere on the board
+5V: C27.1, C28.1, C29.1, C30.1, C31.1, C34.1, C38.1, D3.2 (A), J4.1, U3.3 (VIN), U4.3 (VIN), U5.1 (IN), U5.3 (EN); also elsewhere on the board
/ADS1292R/AVDD: C41.1, C42.1, L3.2; also elsewhere on the board
/SUPPLY/AVSS: C42.2; also elsewhere on the board
Earth: C27.2, C28.2, C29.2, C30.2, C31.2, C32.2, C33.2, C34.2, C35.2, C36.2, C37.2, C38.2, C39.2, C40.2, C41.2, J4.2, J4.3, R23.2, R24.2, U3.1 (GND), U4.1 (GND), U5.2 (GND); also elsewhere on the board
unnamed: C37.1, R22.2, R23.1, U5.4 (FB)
unnamed: D3.1 (K), R24.1

Notes on the sheet:
POWER SUPPLY +3.3VDC ONION OMEGA
MICRO USB CONECTOR
Indicador de Encendido
POWER SUPPLY +3.3VDC MCU BLUETOOTH

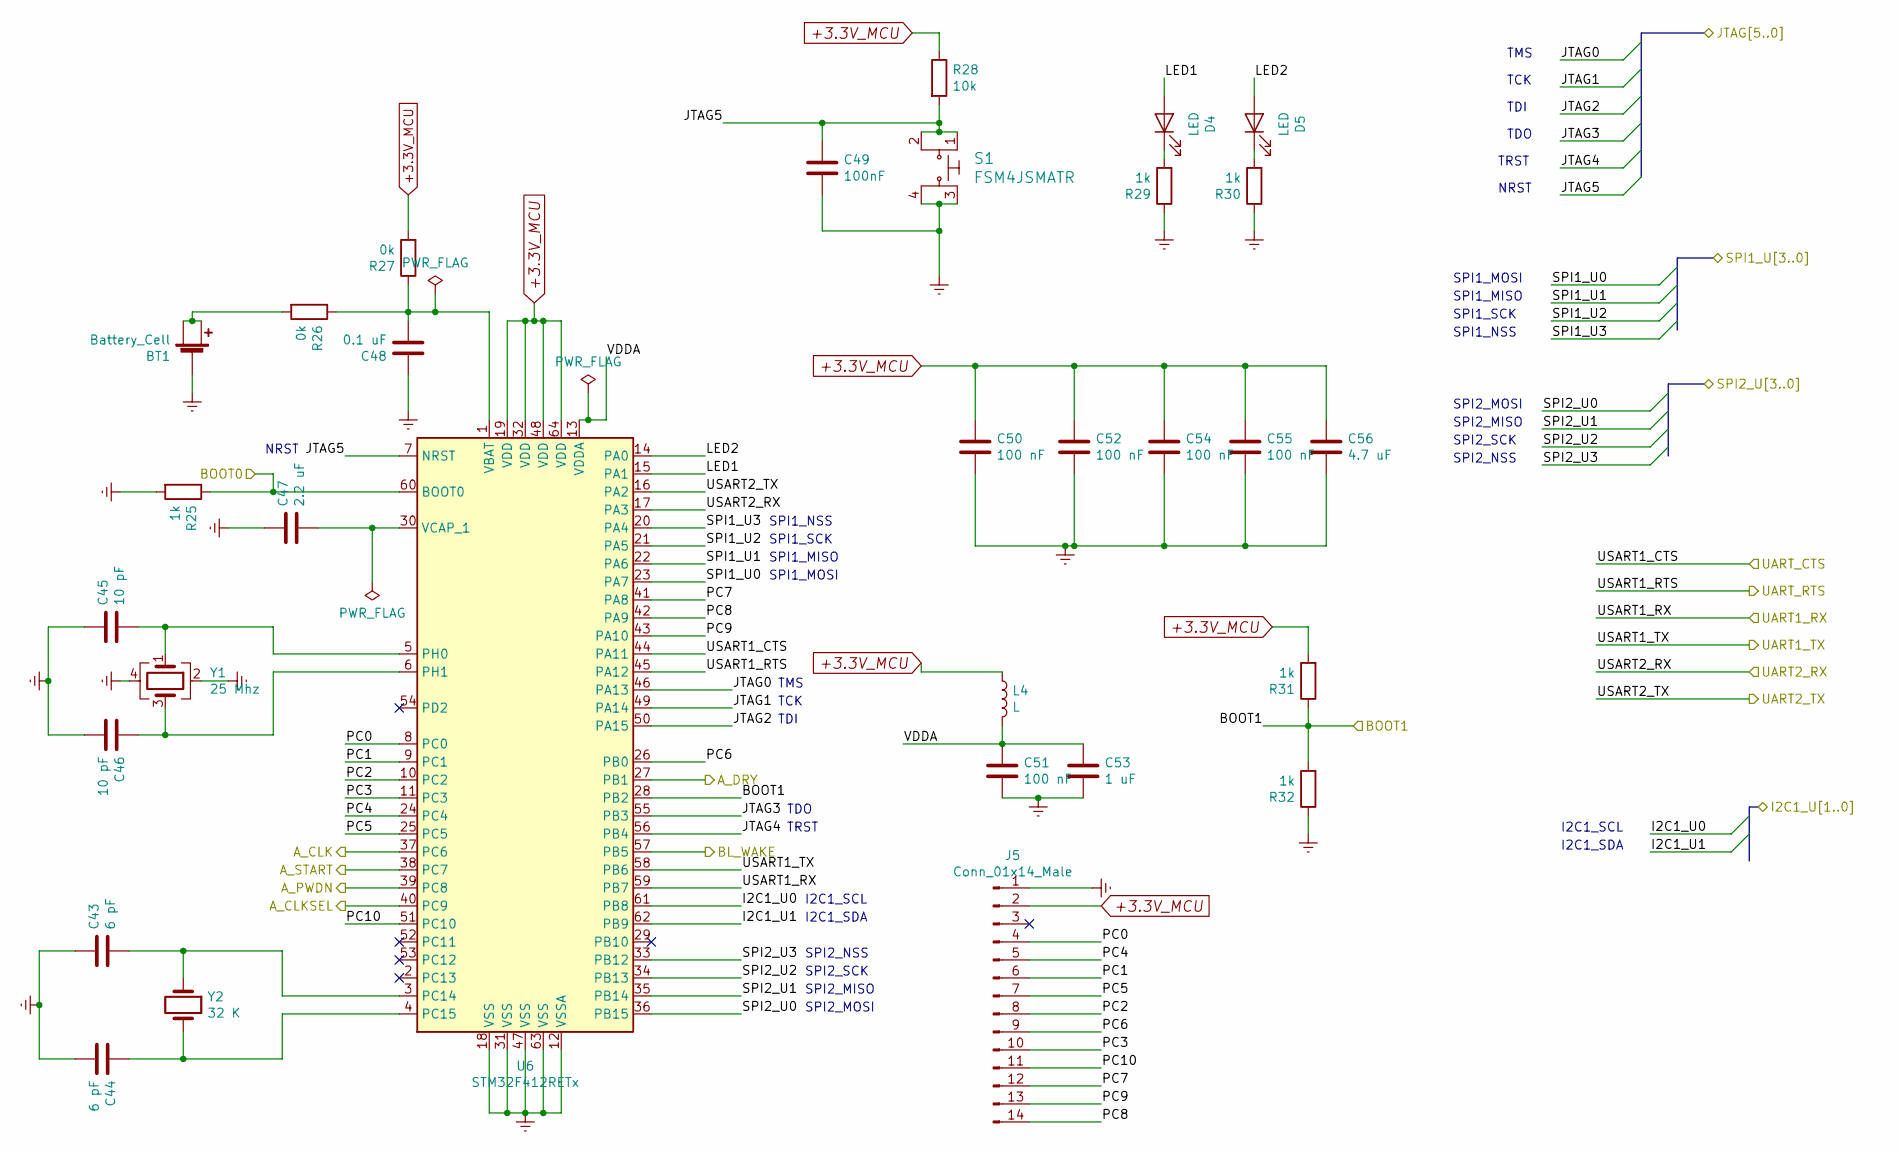
[picture p33: schematic STM32.sch]

Parts:
BT1: Battery_Cell; BAT-HLD-001
C43, C44: 6 pF; C_0603_1608Metric_Pad1.05x0.95mm_HandSolder
C45, C46: 10 pF; C_0603_1608Metric_Pad1.05x0.95mm_HandSolder
C47: 2.2 uF; C_0603_1608Metric_Pad1.05x0.95mm_HandSolder
C48: 0.1 uF; C_0603_1608Metric_Pad1.05x0.95mm_HandSolder
C49: 100nF; C_0603_1608Metric_Pad1.05x0.95mm_HandSolder
C50, C51, C52, C54, C55: 100 nF; C_0603_1608Metric_Pad1.05x0.95mm_HandSolder
C53: 1 uF; C_0603_1608Metric_Pad1.05x0.95mm_HandSolder
C56: 4.7 uF; C_0603_1608Metric_Pad1.05x0.95mm_HandSolder
D4, D5: LED; LED_0805_2012Metric_Pad1.15x1.40mm_HandSolder
J5: Conn_01x14_Male; PinHeader_2x07_P2.54mm_Vertical
L4: L; L_0603_1608Metric_Pad1.05x0.95mm_HandSolder
R25, R29, R30, R31, R32: 1k; R_0603_1608Metric_Pad1.05x0.95mm_HandSolder
R26, R27: 0k; R_0603_1608Metric_Pad1.05x0.95mm_HandSolder
R28: 10k; R_0603_1608Metric_Pad1.05x0.95mm_HandSolder
S1: FSM4JSMATR; Switch_Tactile_SMD_6x6mm; MPN FSM4JSMATR; Digi-Key_PN 450-1759-1-ND
U6: STM32F412RETx; LQFP-64_10x10mm_P0.5mm
Y1: 25 Mhz; Crystal_SMD_Abracon_ABM8G-4Pin_3.2x2.5mm
Y2: 32 K; NX3215SA

Connections:
+3.3V_MCU: C50.1, C52.1, C54.1, C55.1, C56.1, J5.2, L4.1, R27.2, R28.1, R31.2, U6.19 (VDD), U6.32 (VDD), U6.48 (VDD), U6.64 (VDD); also elsewhere on the board
/ADS1292R/SPI_ADS0: U6.36 (PB15); also elsewhere on the board
/ADS1292R/SPI_ADS1: U6.35 (PB14); also elsewhere on the board
/ADS1292R/SPI_ADS2: U6.34 (PB13); also elsewhere on the board
/ADS1292R/SPI_ADS3: U6.33 (PB12); also elsewhere on the board
/BLUETOOTH/Bluetooth_RTS: U6.44 (PA11); also elsewhere on the board
/BLUETOOTH/Bluetooth_TX: U6.59 (PB7); also elsewhere on the board
/OMEGA2/BOOT0: R25.1, U6.60 (BOOT0); also elsewhere on the board
/OMEGA2/BOOT1: R31.1, R32.2, U6.28 (PB2); also elsewhere on the board
/OMEGA2/I2C_OM0: U6.61 (PB8); also elsewhere on the board
/OMEGA2/I2C_OM1: U6.62 (PB9); also elsewhere on the board
/OMEGA2/USART_TX: U6.17 (PA3); also elsewhere on the board
/STM32/A_CLK: U6.37 (PC6); also elsewhere on the board
/STM32/A_CLKSEL: U6.40 (PC9); also elsewhere on the board
/STM32/A_DRY: U6.27 (PB1); also elsewhere on the board
/STM32/A_PWDN: U6.39 (PC8); also elsewhere on the board
/STM32/A_START: U6.38 (PC7); also elsewhere on the board
/STM32/BL_WAKE: U6.57 (PB5); also elsewhere on the board
/STM32/JTAG0: U6.46 (PA13); also elsewhere on the board
/STM32/JTAG1: U6.49 (PA14); also elsewhere on the board
/STM32/JTAG2: U6.50 (PA15); also elsewhere on the board
/STM32/JTAG3: U6.55 (PB3); also elsewhere on the board
/STM32/JTAG4: U6.56 (PB4); also elsewhere on the board
/STM32/JTAG5: C49.1, R28.2, S1.1, S1.2, U6.7 (NRST); also elsewhere on the board
/STM32/LED1: D4.2 (A), U6.15 (PA1)
/STM32/LED2: D5.2 (A), U6.14 (PA0)
/STM32/PC0: J5.4, U6.8 (PC0)
/STM32/PC1: J5.6, U6.9 (PC1)
/STM32/PC2: J5.8, U6.10 (PC2)
/STM32/PC3: J5.10, U6.11 (PC3)
/STM32/PC4: J5.5, U6.24 (PC4)
/STM32/PC5: J5.7, U6.25 (PC5)
/STM32/PC6: J5.9, U6.26 (PB0)
/STM32/PC7: J5.12, U6.41 (PA8)
/STM32/PC8: J5.14, U6.42 (PA9)
/STM32/PC9: J5.13, U6.43 (PA10)
/STM32/PC10: J5.11, U6.51 (PC10)
/STM32/SPI1_U0: U6.23 (PA7); also elsewhere on the board
/STM32/SPI1_U1: U6.22 (PA6); also elsewhere on the board
/STM32/SPI1_U2: U6.21 (PA5); also elsewhere on the board
/STM32/SPI1_U3: U6.20 (PA4); also elsewhere on the board
/STM32/UART1_TX: U6.58 (PB6); also elsewhere on the board
/STM32/UART2_TX: U6.16 (PA2); also elsewhere on the board
/STM32/UART_RTS: U6.45 (PA12); also elsewhere on the board
/STM32/VDDA: C51.1, C53.1, L4.2, U6.13 (VDDA)
Earth: BT1.2 (-), C43.1, C44.2, C45.1, C46.2, C47.1, C48.1, C49.2, C50.2, C51.2, C52.2, C53.2, C54.2, C55.2, C56.2, J5.1, R25.2, R29.1, R30.1, R32.1, S1.3, S1.4, U6.12 (VSSA), U6.18 (VSS), U6.31 (VSS), U6.47 (VSS), U6.63 (VSS), Y1.2, Y1.4; also elsewhere on the board
unnamed: BT1.1 (+), BT1.3 (+), R26.2
unnamed: C43.2, U6.3 (PC14), Y2.1
unnamed: C44.1, U6.4 (PC15), Y2.2
unnamed: C45.2, U6.5 (PH0), Y1.1
unnamed: C46.1, U6.6 (PH1), Y1.3
unnamed: C47.2, U6.30 (VCAP_1)
unnamed: C48.2, R26.1, R27.1, U6.1 (VBAT)
unnamed: D4.1 (K), R29.2
unnamed: D5.1 (K), R30.2

Notes on the sheet:
TMS
TCK
TDI
TRST
NRST
TDO
SPI1_MOSI
SPI1_MISO
SPI1_SCK
SPI1_NSS
SPI2_MOSI
SPI2_MISO
SPI2_SCK
SPI2_NSS
I2C1_SCL
I2C1_SDA

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
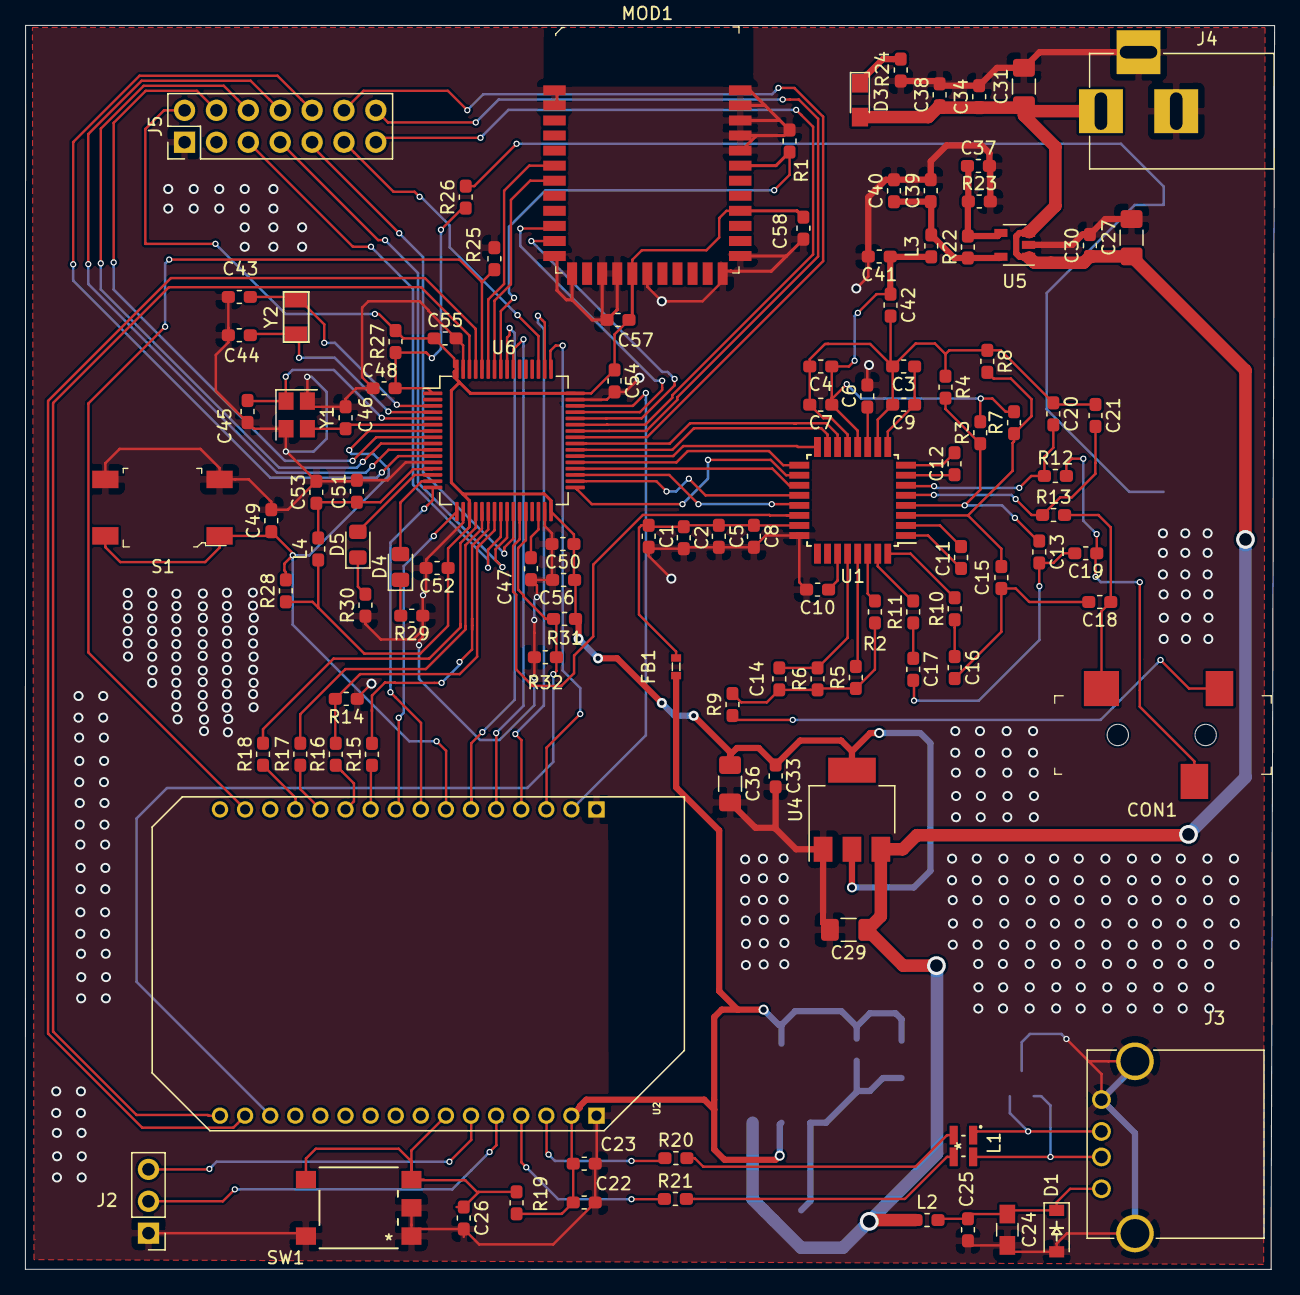
[picture p34: board Embebidos_2019.kicad_pcb from above]

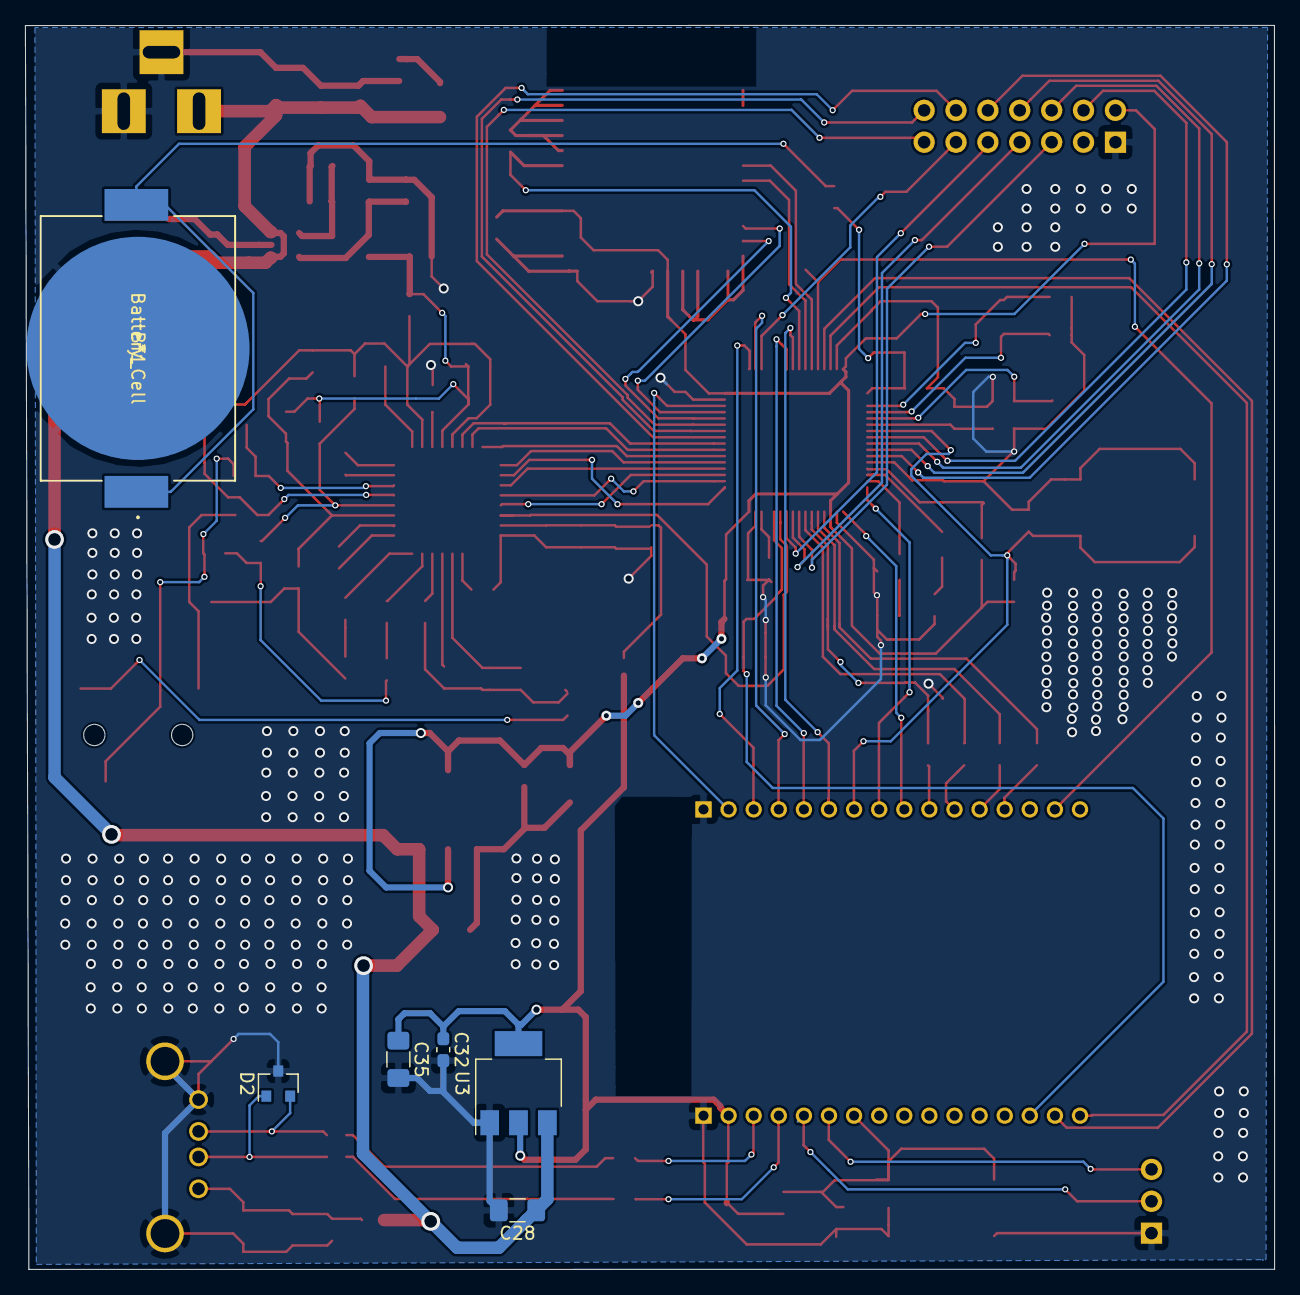
[picture p35: board Embebidos_2019.kicad_pcb from below]

Board: 2 copper layers, 99.5 x 99.1 mm, 117 parts (6 on the bottom side), 101 nets.
