eayaras/Proyecto/(commit log)

2019-06-02 los archivos ya fueron modificados
    [Embebidos_2019.kicad_pcb]
2019-06-02 los archivos ya fueron modificados, por fin subio
    [ADS1292R.sch, BLUETOOTH.sch, Embebidos_2019.kicad_pcb, Embebidos_2019.sch, OMEGA2.sch, STM32.sch, SUPPLY.sch]
2019-06-02 Bueno esto casi me saca canas, esta es la ultima version ya puedes editar
    [Embebidos_2019.kicad_pcb]
2019-06-06 ultima version
    [ADS1292R.sch, BLUETOOTH.sch, Embebidos_2019.kicad_pcb, Embebidos_2019.sch, OMEGA2.sch, STM32.sch, SUPPLY.sch]
